MekhyW/Drone-VFHL-R1/GIROSCÓPIO/pinout-6050.png

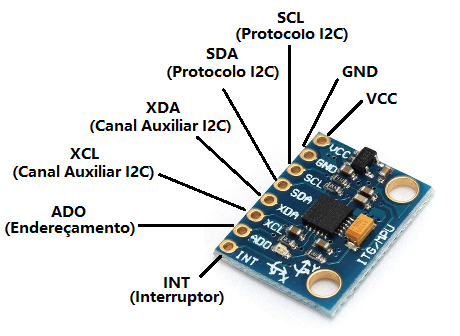
GIROSCÓPIO/pinout-6050.png
