MekhyW/Drone-VFHL-R1/IMAGE/2.jpeg

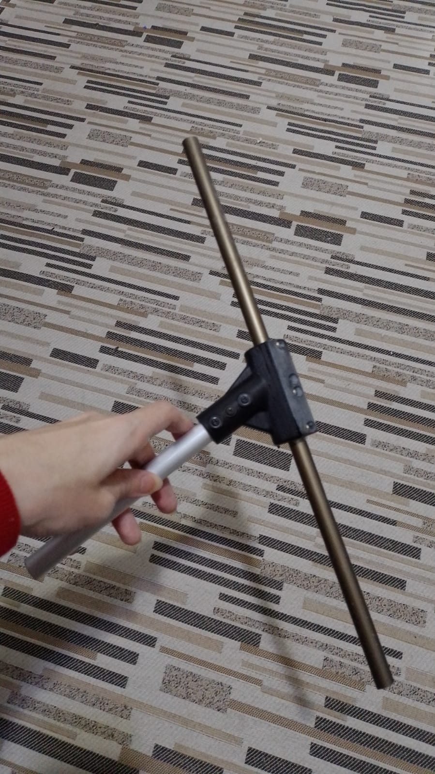
IMAGE/2.jpeg
