MekhyW/Drone-VFHL-R1/DOCUMENTOS/Peças para o projeto .pdf

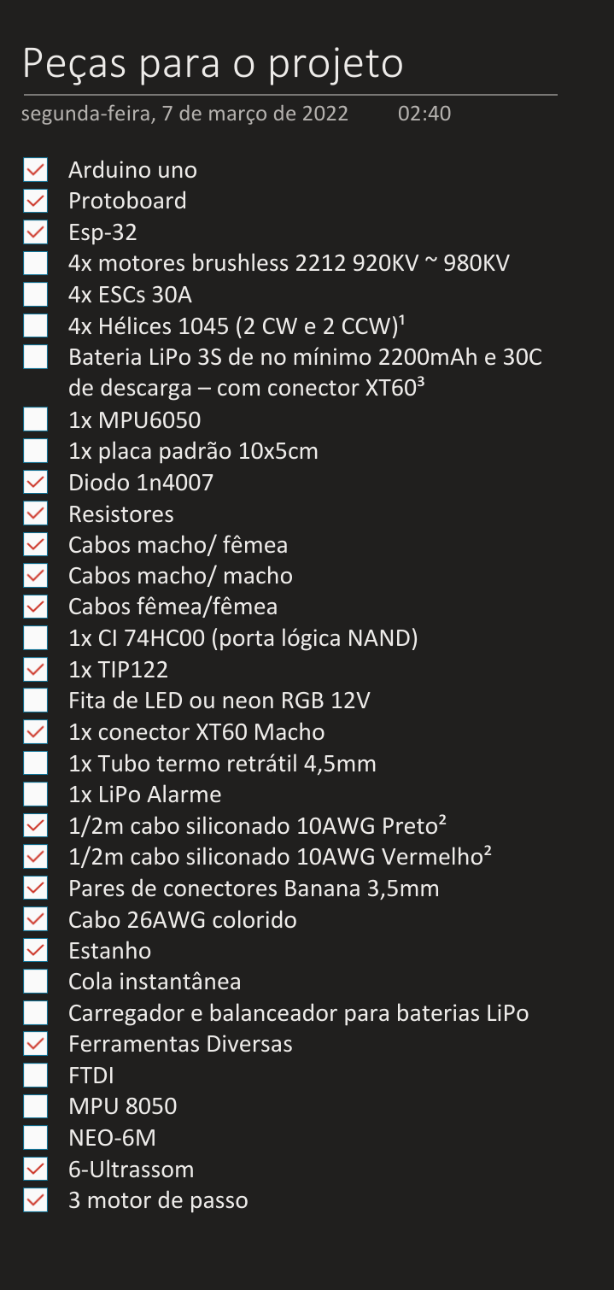
[picture p32: page 1]
