MekhyW/Drone-VFHL-R1/BLUETOOTH/Bluetooth_Level_Converter.png

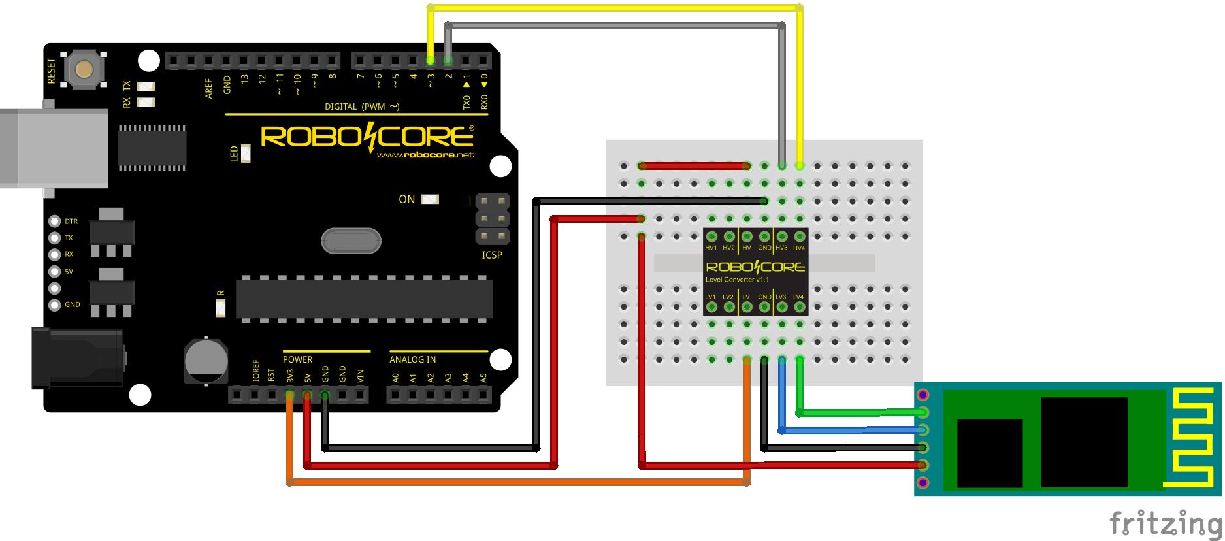
BLUETOOTH/Bluetooth_Level_Converter.png
