MekhyW/Drone-VFHL-R1/Camera Thermal/Camera Thermal/Camera Thermal/Sensor e Display Temp/Fig-4-Potenciometro-ligado-como-divisor-de-tensão-min.webp

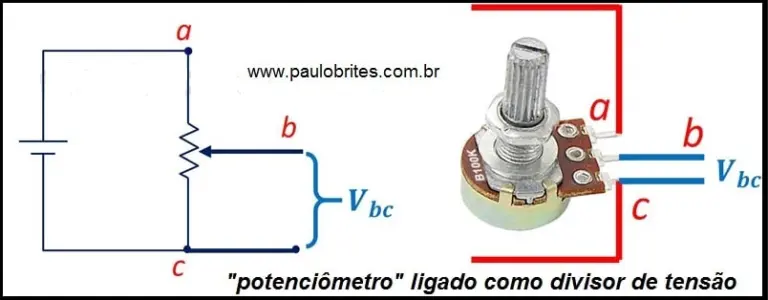
Camera Thermal/Camera Thermal/Camera Thermal/Sensor e Display Temp/Fig-4-Potenciometro-ligado-como-divisor-de-tensão-min.webp
