MekhyW/Drone-VFHL-R1/Camera Thermal/Camera Thermal/Camera Thermal/Sensor e Display Temp/layout.png

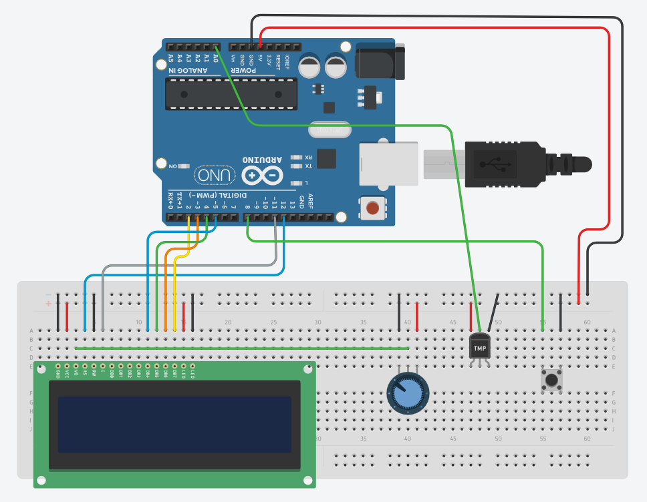
Camera Thermal/Camera Thermal/Camera Thermal/Sensor e Display Temp/layout.png
