MekhyW/Drone-VFHL-R1/Camera Thermal/Camera Thermal/Camera Thermal/Sensor e Display Temp/projeto39.jpg

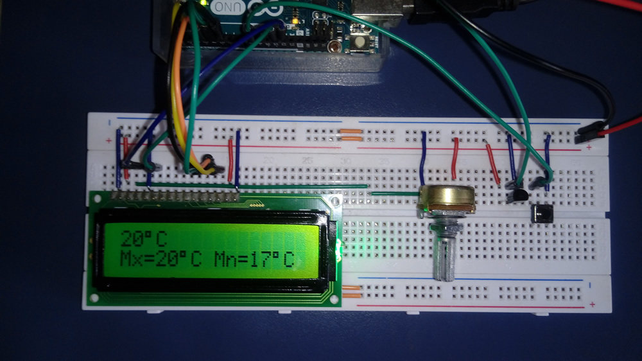
Camera Thermal/Camera Thermal/Camera Thermal/Sensor e Display Temp/projeto39.jpg
