MekhyW/Drone-VFHL-R1/Camera Thermal/Camera Thermal/Camera Thermal/Sensor e Display Temp/Schematic.webp

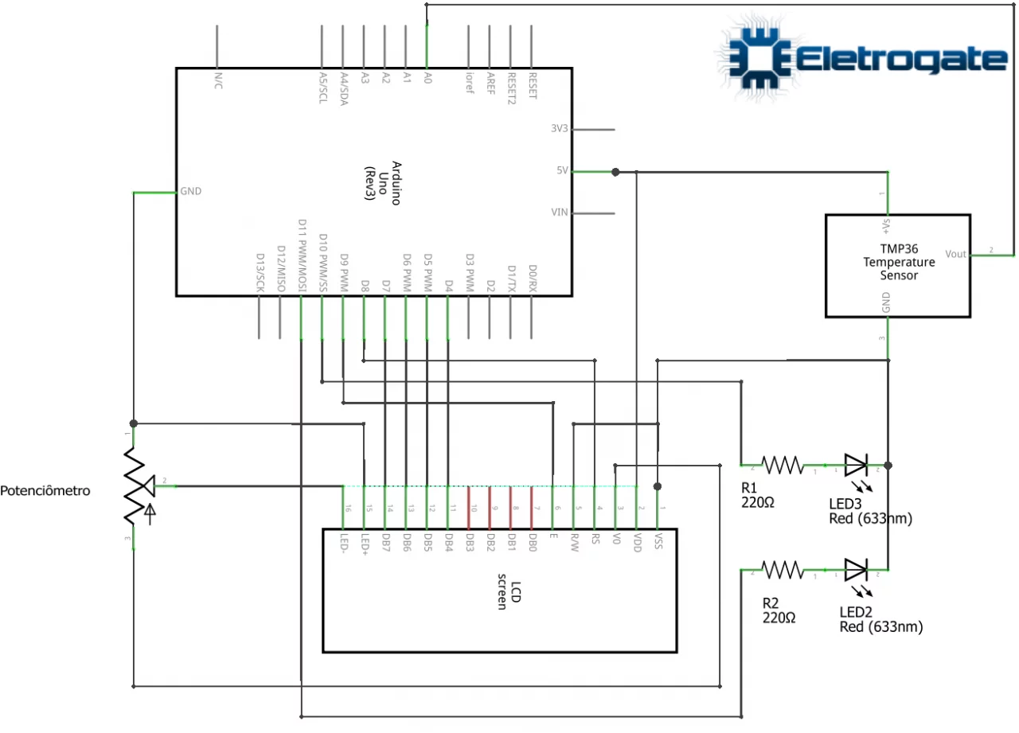
Camera Thermal/Camera Thermal/Camera Thermal/Sensor e Display Temp/Schematic.webp
