MekhyW/Drone-VFHL-R1/Camera Thermal/Camera Thermal/Camera Thermal/Sensor e Display Temp/webpc-passthru (1).webp

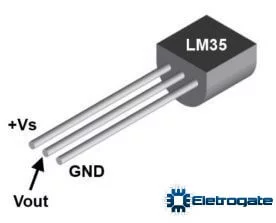
Camera Thermal/Camera Thermal/Camera Thermal/Sensor e Display Temp/webpc-passthru (1).webp
