MekhyW/Drone-VFHL-R1/Camera Thermal/Camera Thermal/Camera Thermal/Sensor e Display Temp/webpc-passthru.webp

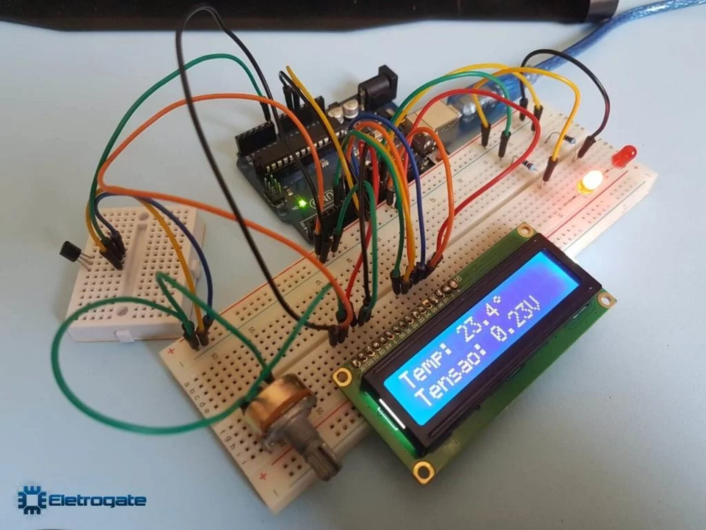
Camera Thermal/Camera Thermal/Camera Thermal/Sensor e Display Temp/webpc-passthru.webp
