MekhyW/Drone-VFHL-R1/Camera Thermal/Camera Thermal/Camera Thermal/virtualPainel.png

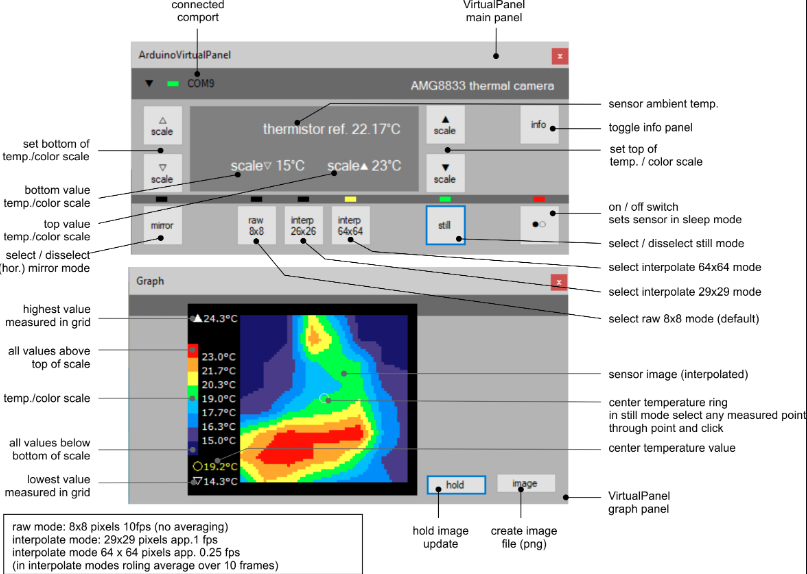
Camera Thermal/Camera Thermal/Camera Thermal/virtualPainel.png
