MekhyW/Drone-VFHL-R1/Camera Thermal/Camera Thermal/Datasheet.png

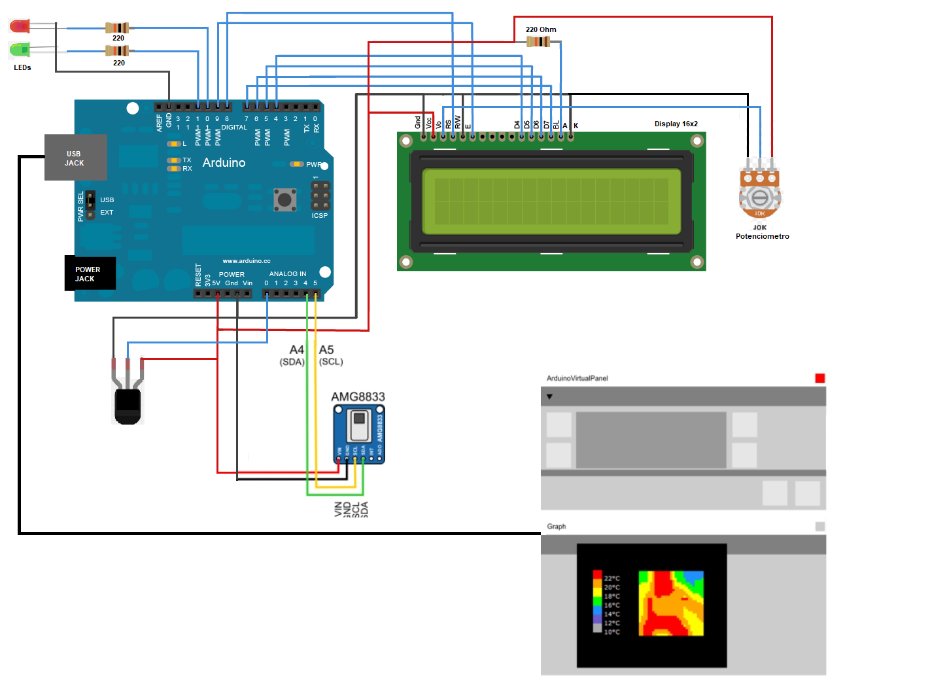
Camera Thermal/Camera Thermal/Datasheet.png
