MekhyW/Drone-VFHL-R1/DOCUMENTOS/CI 74HC00.png

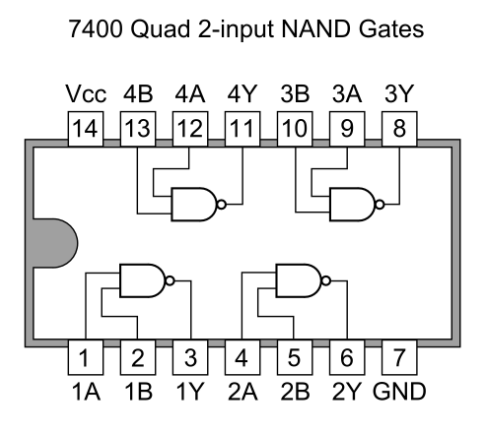
DOCUMENTOS/CI 74HC00.png
