MekhyW/Drone-VFHL-R1/DOCUMENTOS/Diagrama Completo.png

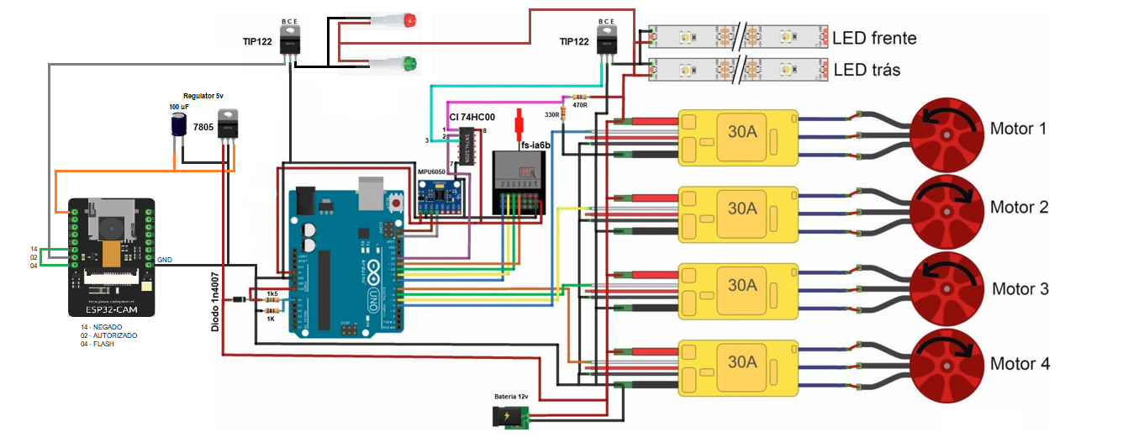
DOCUMENTOS/Diagrama Completo.png
