MekhyW/Drone-VFHL-R1/DOCUMENTOS/esquematico-quad-2-scaled-1-1536x750.jpg

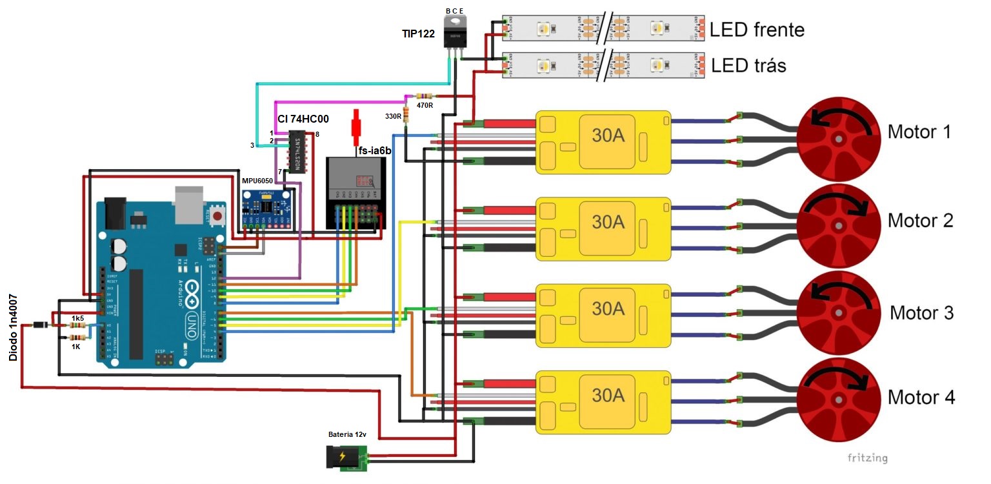
DOCUMENTOS/esquematico-quad-2-scaled-1-1536x750.jpg
