MekhyW/Drone-VFHL-R1/DOCUMENTOS/SUPORTE FLYSKY.png

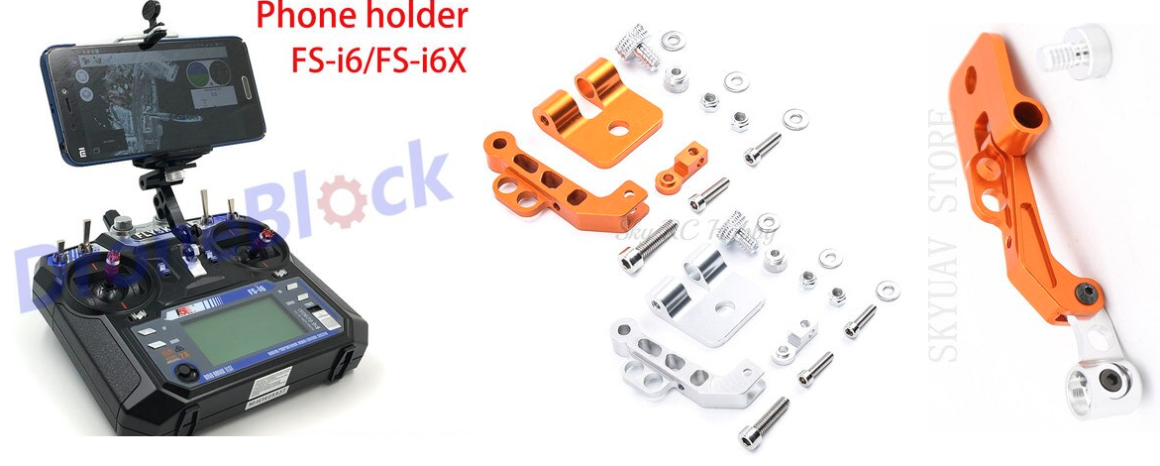
DOCUMENTOS/SUPORTE FLYSKY.png
