MekhyW/Drone-VFHL-R1/DOCUMENTOS/TIP122.png

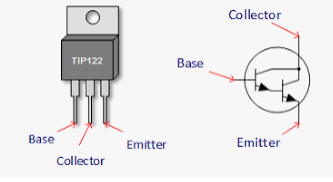
DOCUMENTOS/TIP122.png
