MekhyW/Drone-VFHL-R1/ESC/Circuito-Arduino-Uno-Motor-Brushless-1024x719.png

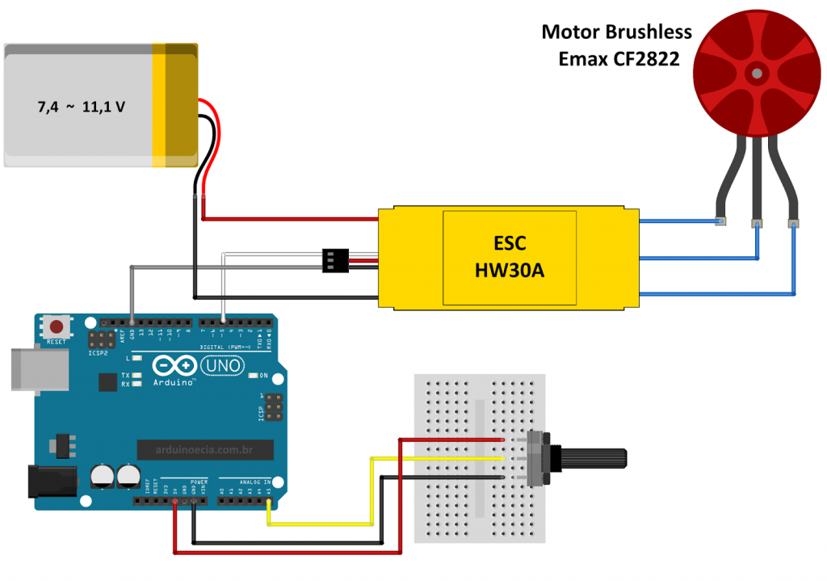
ESC/Circuito-Arduino-Uno-Motor-Brushless-1024x719.png
