MekhyW/Drone-VFHL-R1/ESP32/ESP32-CAM_FTDI_3bb.png

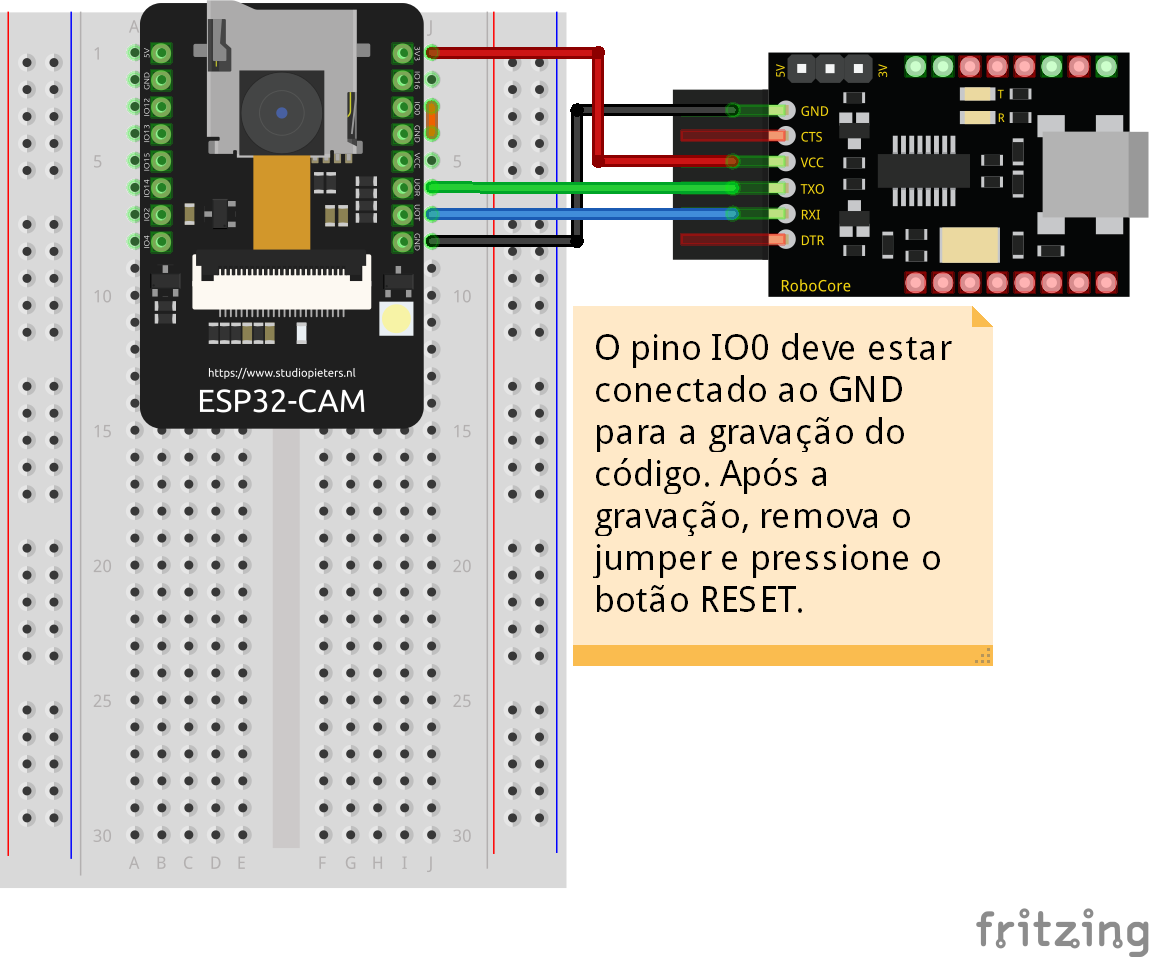
ESP32/ESP32-CAM_FTDI_3bb.png
