MekhyW/Drone-VFHL-R1/ESP32/features-esp32.png

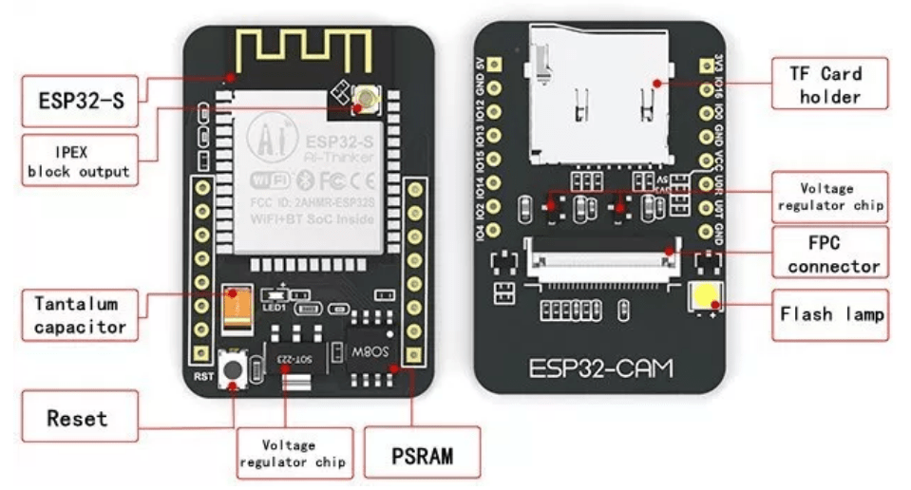
ESP32/features-esp32.png
