MekhyW/Drone-VFHL-R1/GIROSCÓPIO/circuito_dois_mpu6050-768x534.jpg

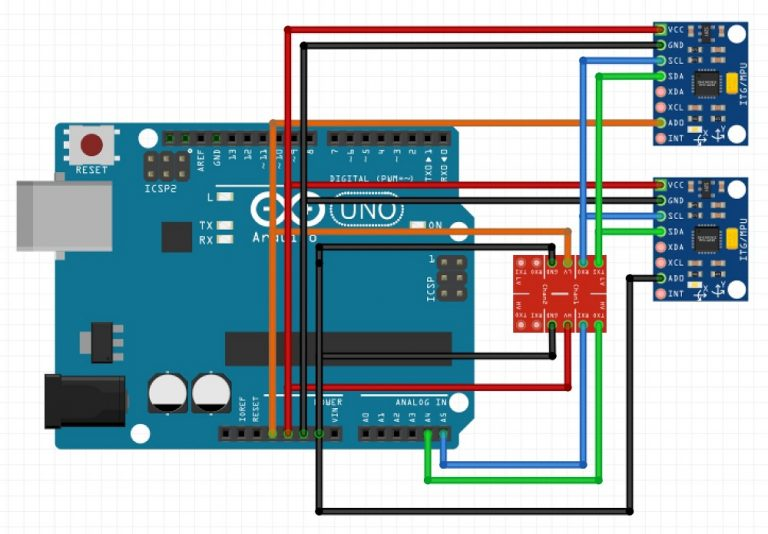
GIROSCÓPIO/circuito_dois_mpu6050-768x534.jpg
