MekhyW/Drone-VFHL-R1/GIROSCÓPIO/circuito_mpu6050-768x440.jpg

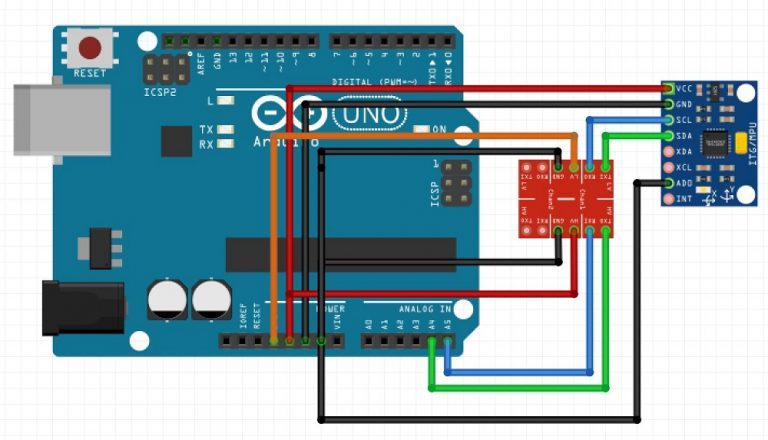
GIROSCÓPIO/circuito_mpu6050-768x440.jpg
