MekhyW/Drone-VFHL-R1/GIROSCÓPIO/GY-521-MPU-6050-Pinos1.jpg

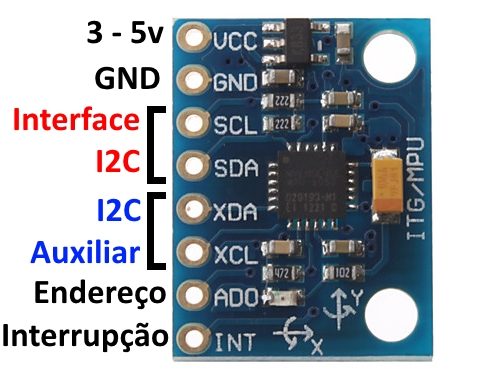
GIROSCÓPIO/GY-521-MPU-6050-Pinos1.jpg
