MekhyW/Drone-VFHL-R1/IMAGE/4.jpeg

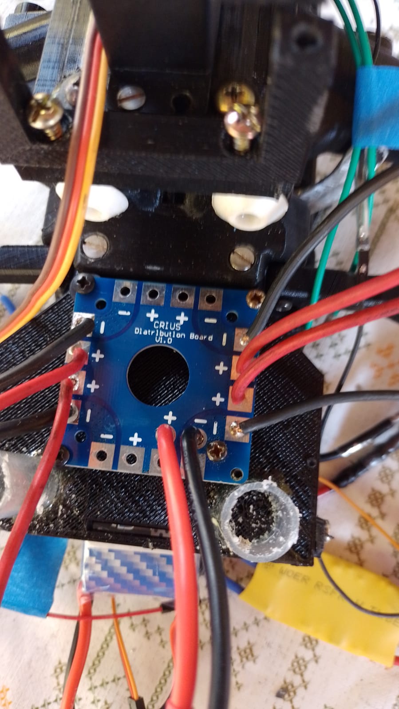
IMAGE/4.jpeg
