MekhyW/Drone-VFHL-R1/IMAGE/5.jpeg

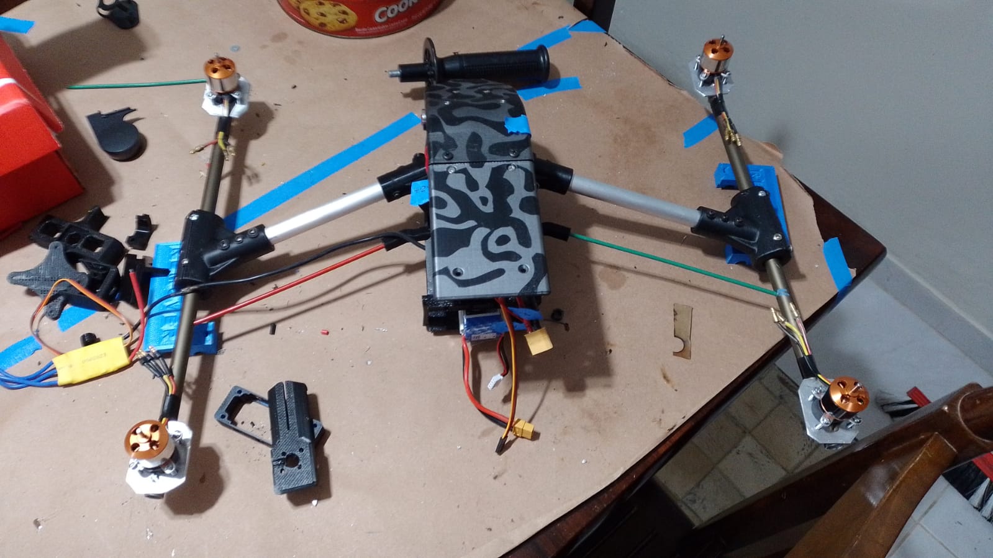
IMAGE/5.jpeg
