MekhyW/Drone-VFHL-R1/IMAGE/6.jpeg

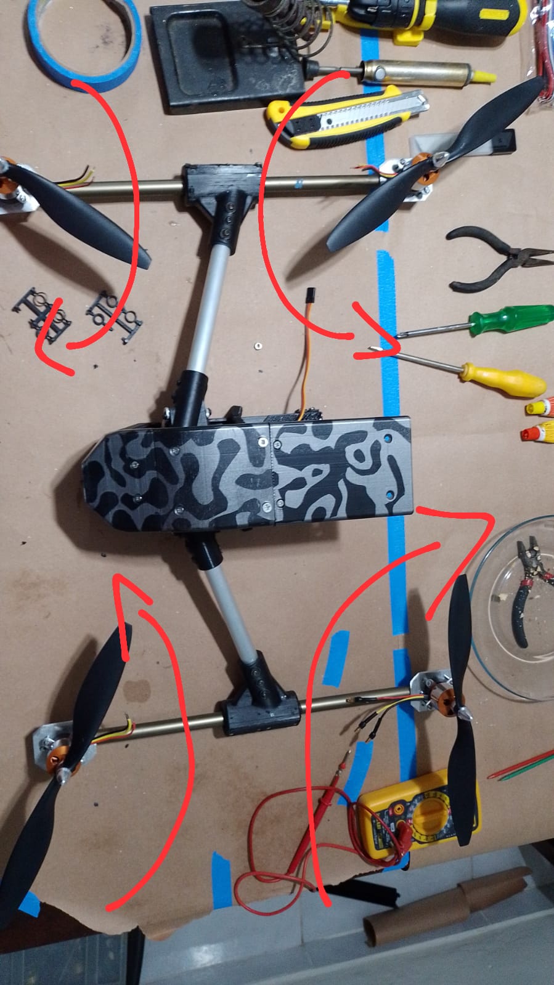
IMAGE/6.jpeg
