MekhyW/Drone-VFHL-R1/IMAGE/WhatsApp Image 2022-05-19 at 20.57.54.jpeg

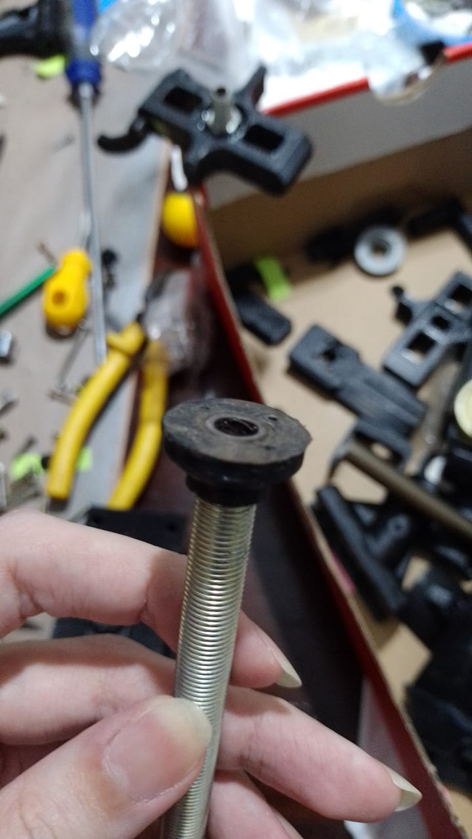
IMAGE/WhatsApp Image 2022-05-19 at 20.57.54.jpeg
