MekhyW/Drone-VFHL-R1/IMAGE/WhatsApp Image 2022-05-21 at 18.13.55 (1).jpeg

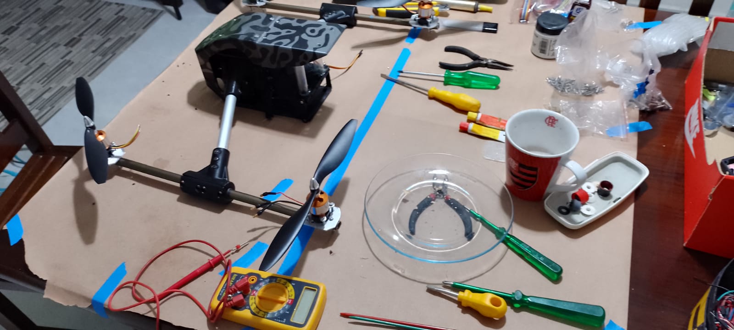
IMAGE/WhatsApp Image 2022-05-21 at 18.13.55 (1).jpeg
