MekhyW/Drone-VFHL-R1/IMAGE/WhatsApp Image 2022-05-21 at 18.13.55 (2).jpeg

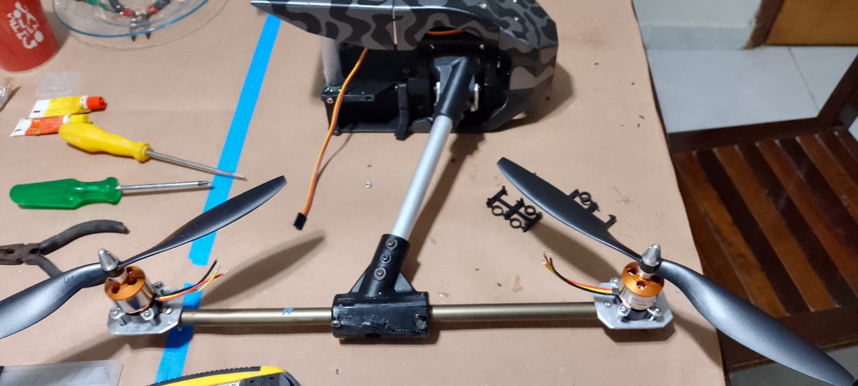
IMAGE/WhatsApp Image 2022-05-21 at 18.13.55 (2).jpeg
