MekhyW/Drone-VFHL-R1/MicroSD/827_3_H.png

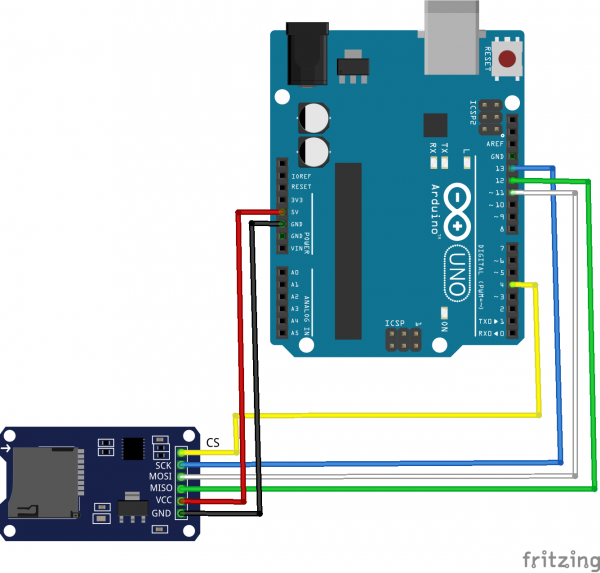
MicroSD/827_3_H.png
