MekhyW/Drone-VFHL-R1/Modulo ESP32/CONFIG IDE 1.png

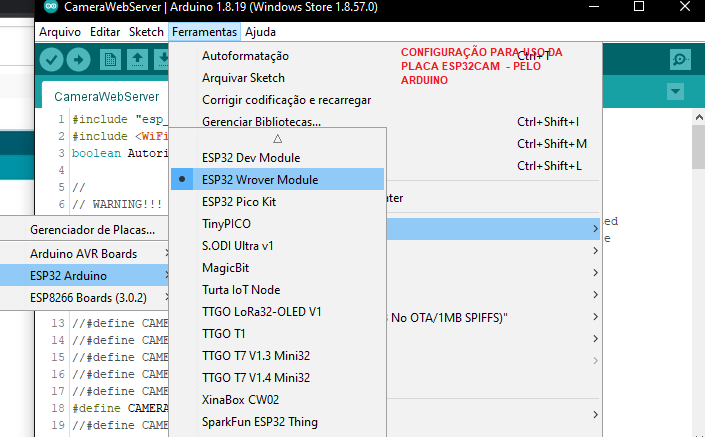
Modulo ESP32/CONFIG IDE 1.png
