MekhyW/Drone-VFHL-R1/Modulo Esp8266/esp_blackversion_ftdi_955.png

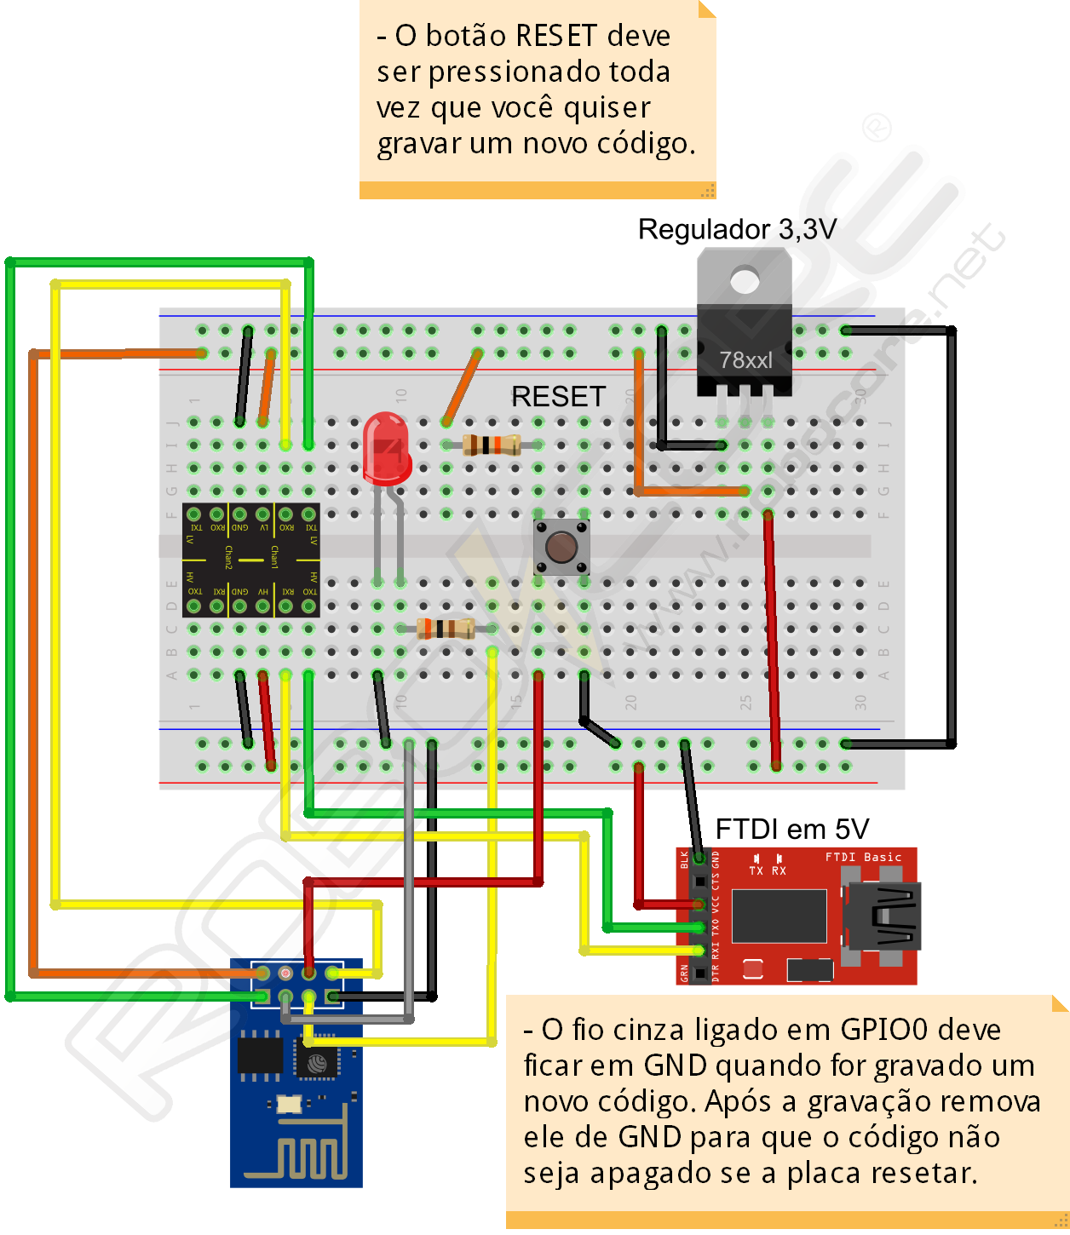
Modulo Esp8266/esp_blackversion_ftdi_955.png
