MekhyW/Drone-VFHL-R1/PCB/1.bmp

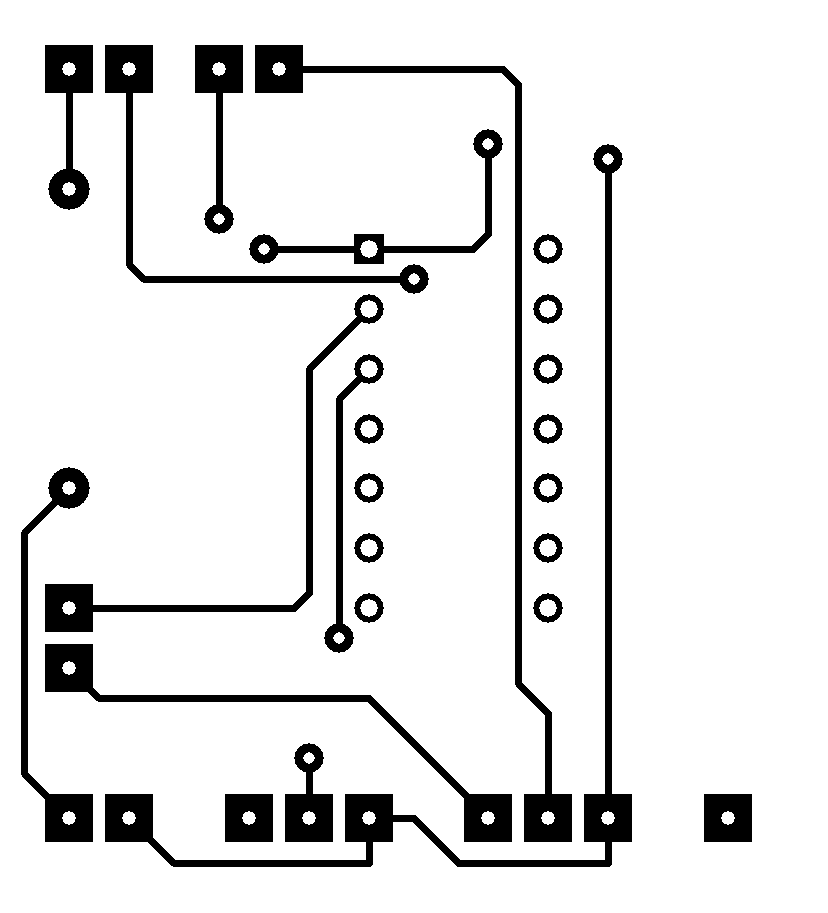
PCB/1.bmp
