MekhyW/Drone-VFHL-R1/PCB/2.bmp

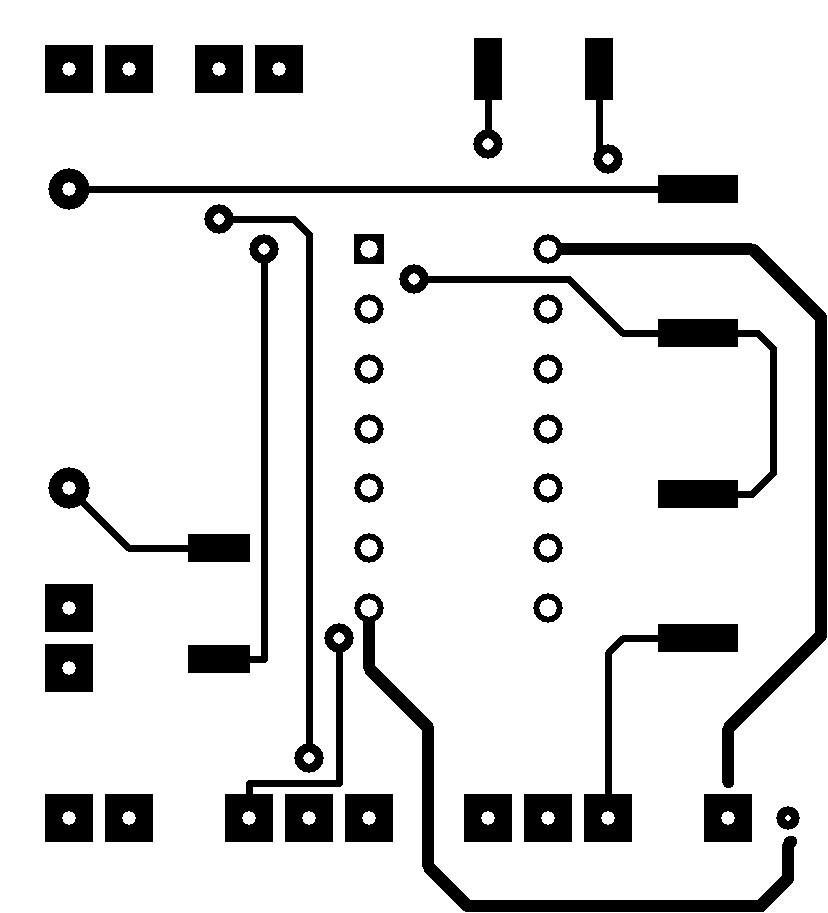
PCB/2.bmp
