MekhyW/Drone-VFHL-R1/DOCUMENTOS/orçamento projeto.xlsx

Quantidade | peças | mercado livre | aliexpress | shoppe | banggood | americanas
4 | Motor Brushless 2212 920KV | R$99.35 | R$145.81 | R$179.12 | R$211.31 | R$94.95
4 | ESCs 30A | R$169.20 | R$207.28 | R$159.60 | R$152.79 | R$265.20
1 | Bateria LiPo 3s 2200mAh | R$144.40 | R$203.57 | R$129.00 | R$154.28 | R$203.62
1 | tubo termo retratil | R$46.30 | R$68.89 | R$26.50 | R$57.03 | R$51.98
1 | carregador e balanceador para bateria LiPo | R$205.20 | R$182.32 | R$130.00 | R$224.00 | R$82.77
1 | Neo-6m (gps) | R$61.99 | R$75.92 | R$38.28 | / | R$74.55
