MekhyW/Drone-VFHL-R1/DRONE 3D/Drone PGE Esamc/Wormdrive_V1.5_M8Round.stl

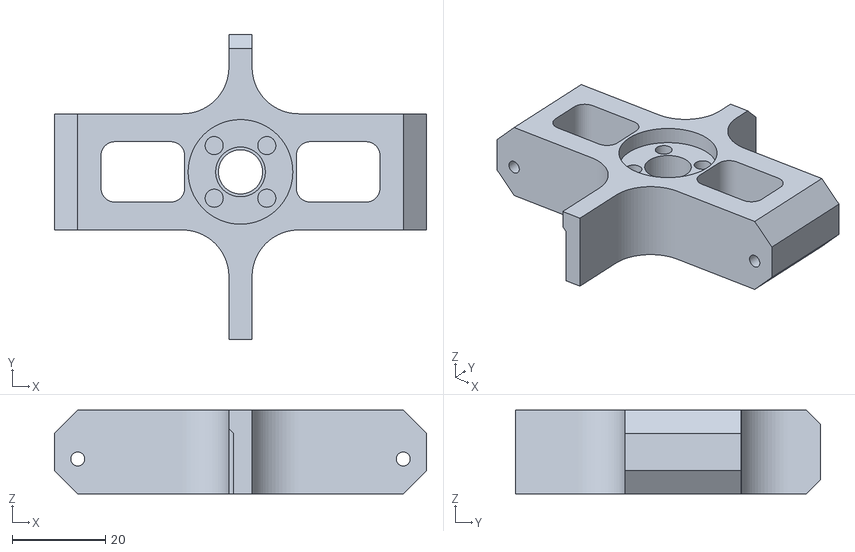
[picture p72: CAD file, 2023-11-14]
DRONE 3D/Drone PGE Esamc/Wormdrive_V1.5_M8Round.stl
80.0 x 65.5 x 18.0
