MekhyW/Drone-VFHL-R1/DRONE 3D/Drone PGE Esamc/Frame_Bushing_Holder_Front_V1.5.stl

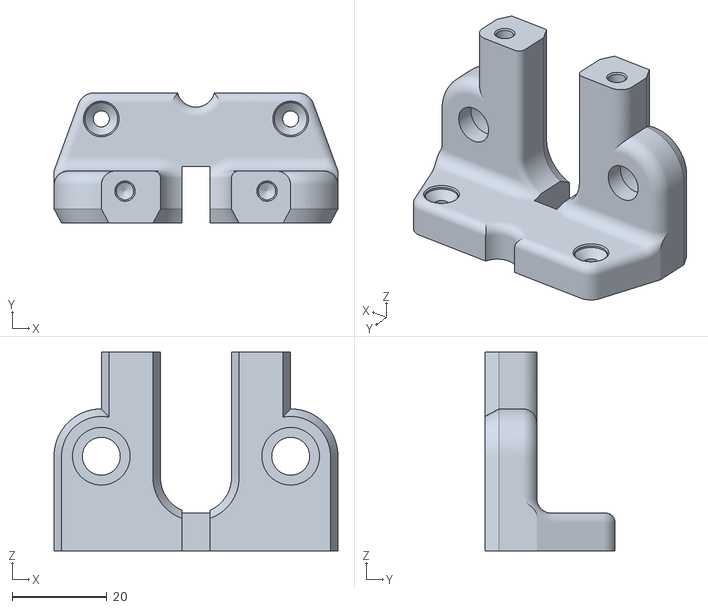
[picture p73: CAD file, 2023-11-14]
DRONE 3D/Drone PGE Esamc/Frame_Bushing_Holder_Front_V1.5.stl
60.0 x 27.5 x 42.0
