MekhyW/Drone-VFHL-R1/DRONE 3D/Drone PGE Esamc/Frame_Bushing_Holder_Rear_V1.5.stl

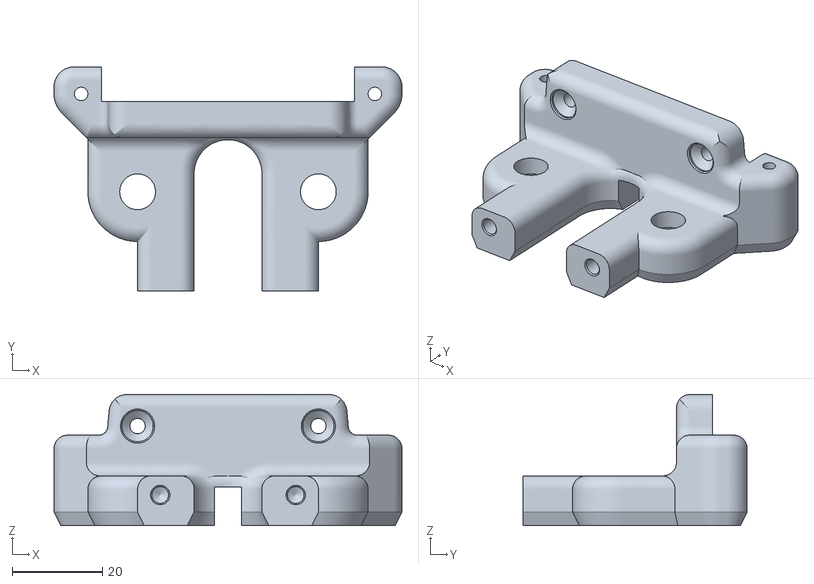
[picture p74: CAD file, 2023-11-14]
DRONE 3D/Drone PGE Esamc/Frame_Bushing_Holder_Rear_V1.5.stl
77.0 x 49.7 x 29.0
