MekhyW/Drone-VFHL-R1/DRONE 3D/Drone PGE Esamc/Boom_Outer_Joint_2_20Deg_R.stl

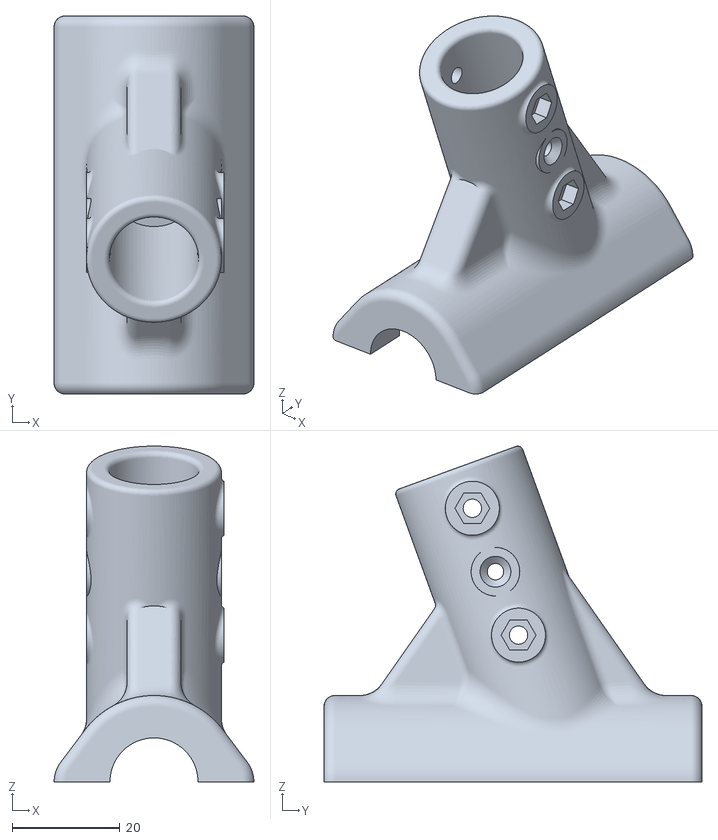
[picture p75: CAD file, 2023-11-14]
DRONE 3D/Drone PGE Esamc/Boom_Outer_Joint_2_20Deg_R.stl
37.0 x 70.0 x 62.2
