MekhyW/Drone-VFHL-R1/DRONE 3D/Drone PGE Esamc/Frame_Joint_Bushing_V1.5.stl

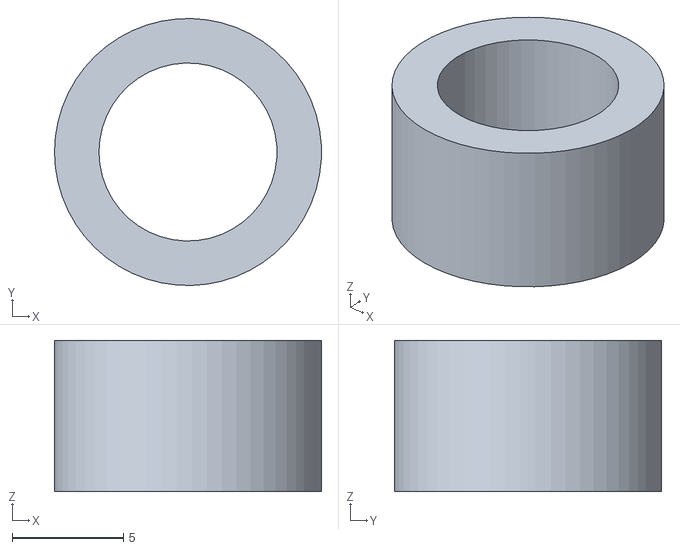
[picture p76: CAD file, 2023-11-14]
DRONE 3D/Drone PGE Esamc/Frame_Joint_Bushing_V1.5.stl
12.0 x 12.0 x 6.80
