MekhyW/Drone-VFHL-R1/DRONE 3D/Drone PGE Esamc/Canopy_Top_V1.5_Split_B.stl

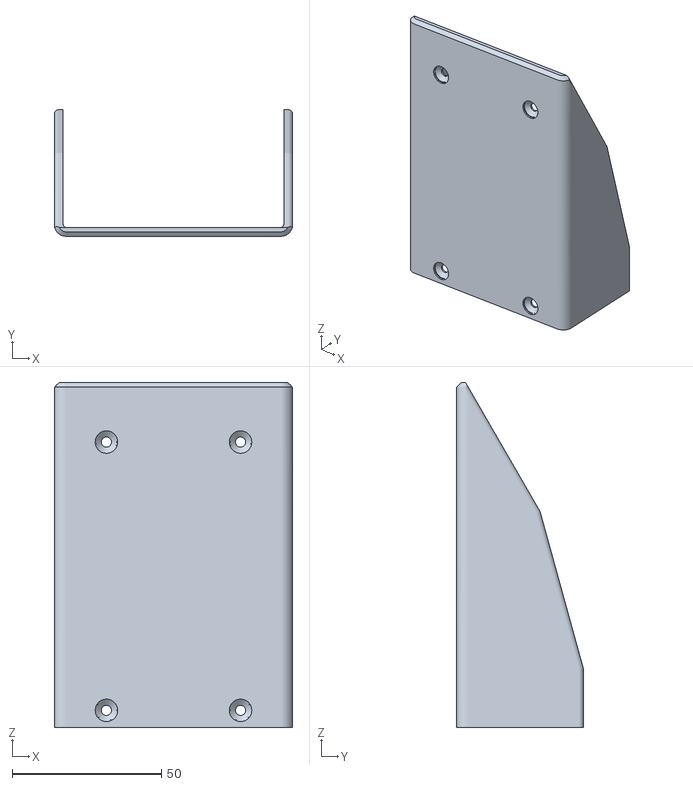
[picture p77: CAD file, 2023-11-14]
DRONE 3D/Drone PGE Esamc/Canopy_Top_V1.5_Split_B.stl
80.0 x 42.5 x 115.7
