MekhyW/Drone-VFHL-R1/DRONE 3D/Drone PGE Esamc/Boom_Support_Linkage_V4_2pc.stl

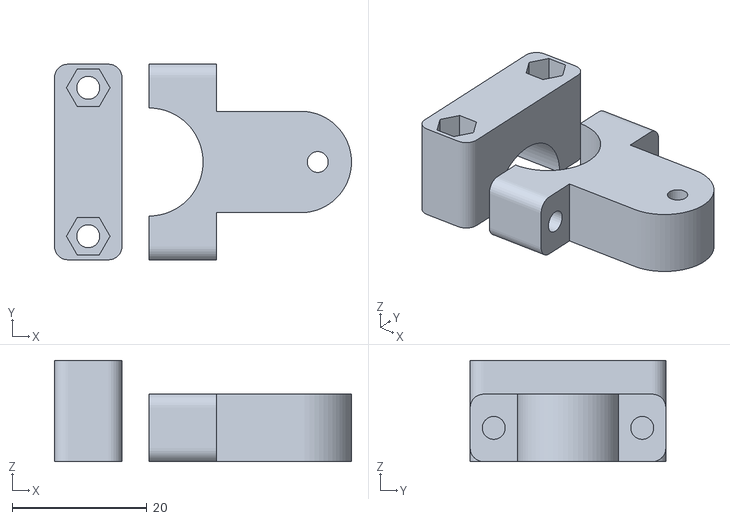
[picture p78: CAD file, 2023-11-14]
DRONE 3D/Drone PGE Esamc/Boom_Support_Linkage_V4_2pc.stl
44.0 x 29.0 x 15.0
