MekhyW/Drone-VFHL-R1/DRONE 3D/Drone PGE Esamc/Boom_Rod_Linkage_20Deg_L.stl

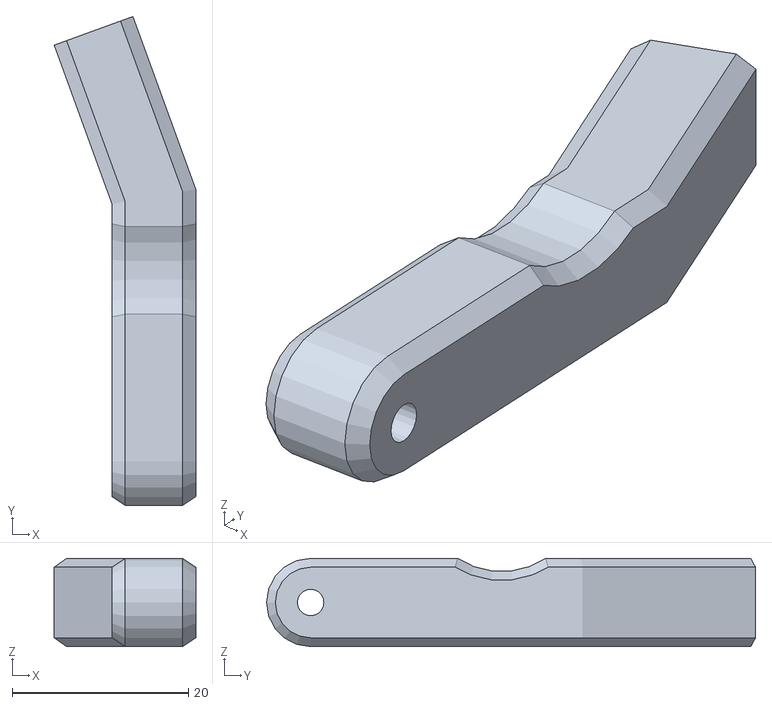
[picture p79: CAD file, 2023-11-14]
DRONE 3D/Drone PGE Esamc/Boom_Rod_Linkage_20Deg_L.stl
16.1 x 55.4 x 10.0
