MekhyW/Drone-VFHL-R1/DRONE 3D/Drone PGE Esamc/Clamp_Angle_Guide.stl

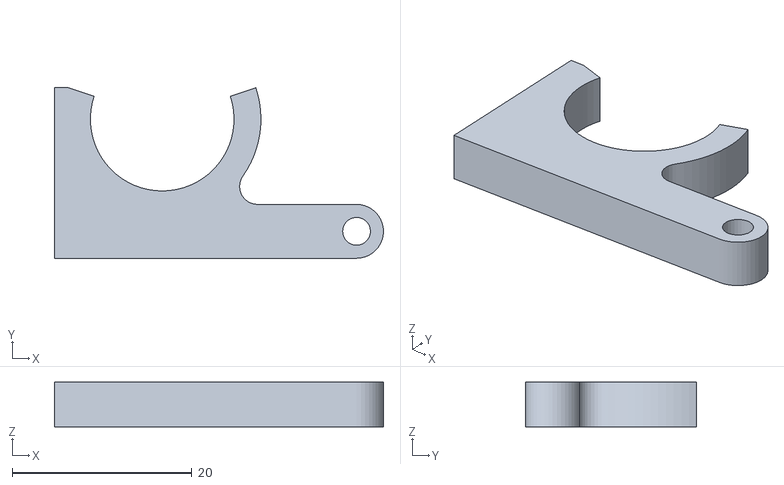
[picture p80: CAD file, 2023-11-14]
DRONE 3D/Drone PGE Esamc/Clamp_Angle_Guide.stl
36.7 x 19.0 x 5.00
