MekhyW/Drone-VFHL-R1/DRONE 3D/Drone PGE Esamc/Frame_Receiver_Shelf_90mm_V1.5.stl

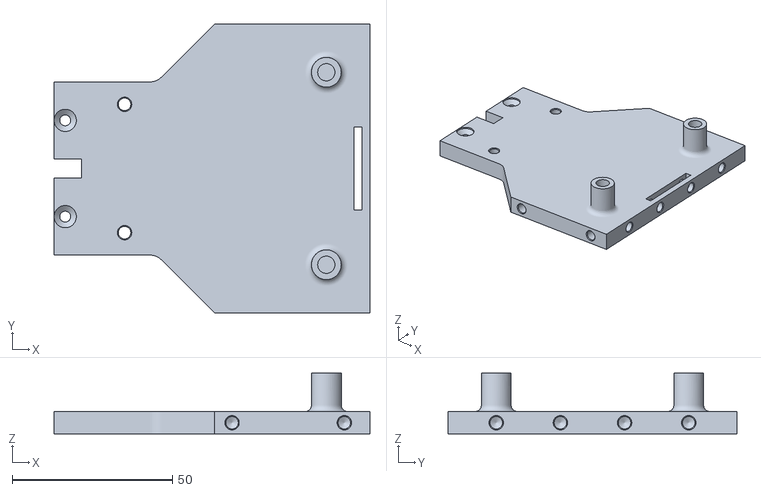
[picture p81: CAD file, 2023-11-14]
DRONE 3D/Drone PGE Esamc/Frame_Receiver_Shelf_90mm_V1.5.stl
98.5 x 90.0 x 19.0
