MekhyW/Drone-VFHL-R1/DRONE 3D/Drone PGE Esamc/Boom_Stop_Ring_V3_2pc.stl

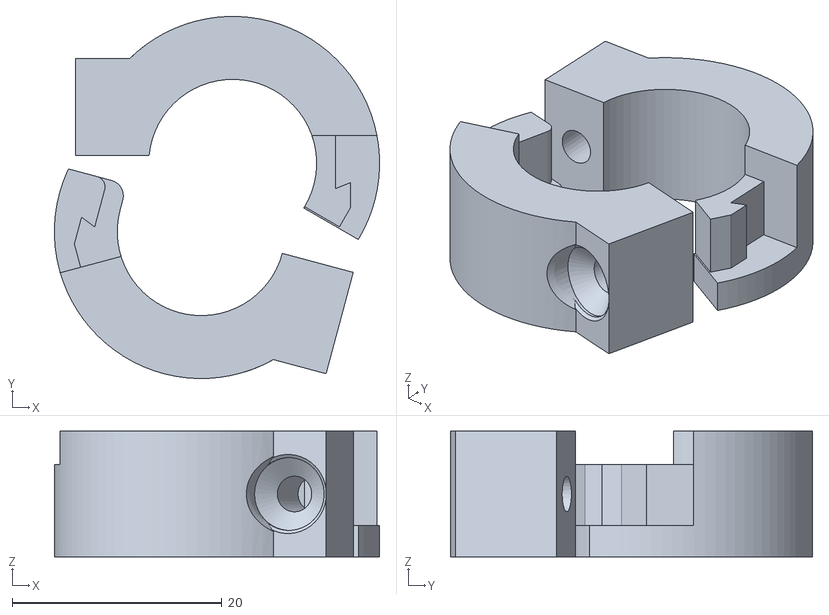
[picture p83: CAD file, 2023-11-14]
DRONE 3D/Drone PGE Esamc/Boom_Stop_Ring_V3_2pc.stl
31.0 x 34.5 x 12.0
