MekhyW/Drone-VFHL-R1/DRONE 3D/Drone PGE Esamc/Frame_Motor_Foot_1_V1.5.stl

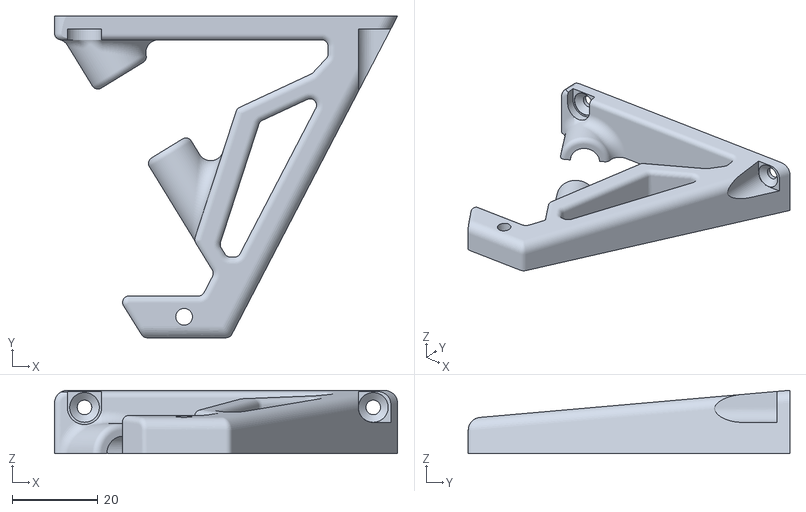
[picture p84: CAD file, 2023-11-14]
DRONE 3D/Drone PGE Esamc/Frame_Motor_Foot_1_V1.5.stl
80.0 x 75.0 x 14.8
