MekhyW/Drone-VFHL-R1/DRONE 3D/Drone PGE Esamc/Canopy_Nose_FPV_V1.5.stl

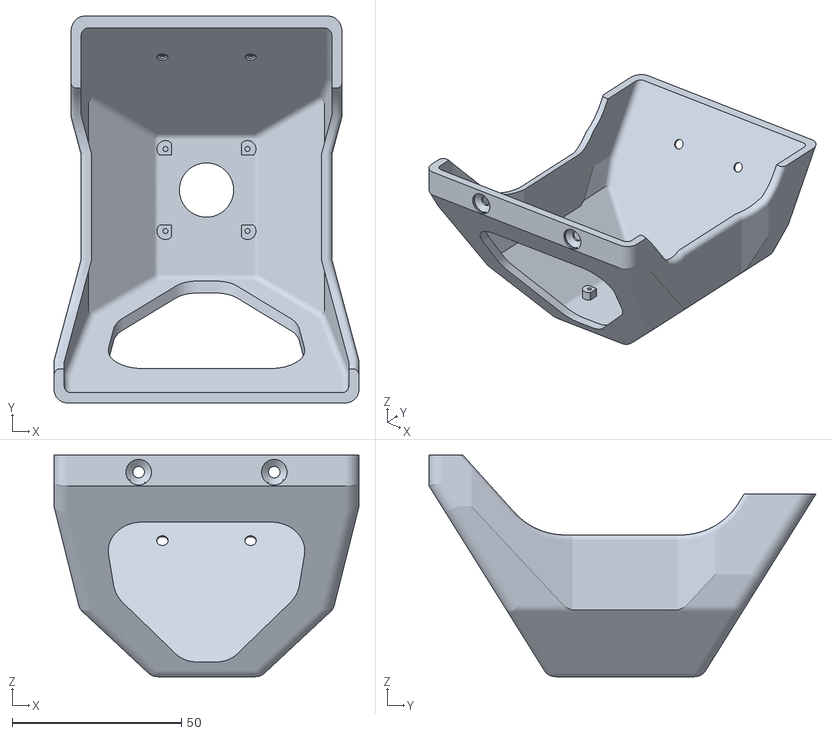
[picture p85: CAD file, 2023-11-14]
DRONE 3D/Drone PGE Esamc/Canopy_Nose_FPV_V1.5.stl
90.0 x 114.1 x 65.4
