MekhyW/Drone-VFHL-R1/DRONE 3D/Drone PGE Esamc/Gimbal_Frame_V1.5.stl

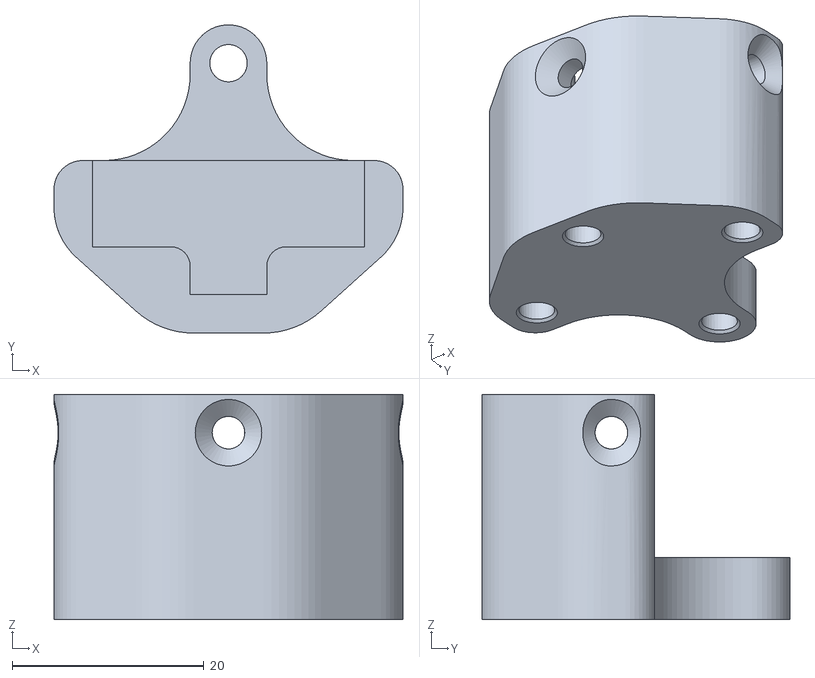
[picture p86: CAD file, 2023-11-14]
DRONE 3D/Drone PGE Esamc/Gimbal_Frame_V1.5.stl
36.4 x 32.1 x 23.5
