MekhyW/Drone-VFHL-R1/DRONE 3D/Drone PGE Esamc/Gimbal_Plate_Diam_40mm_X.stl

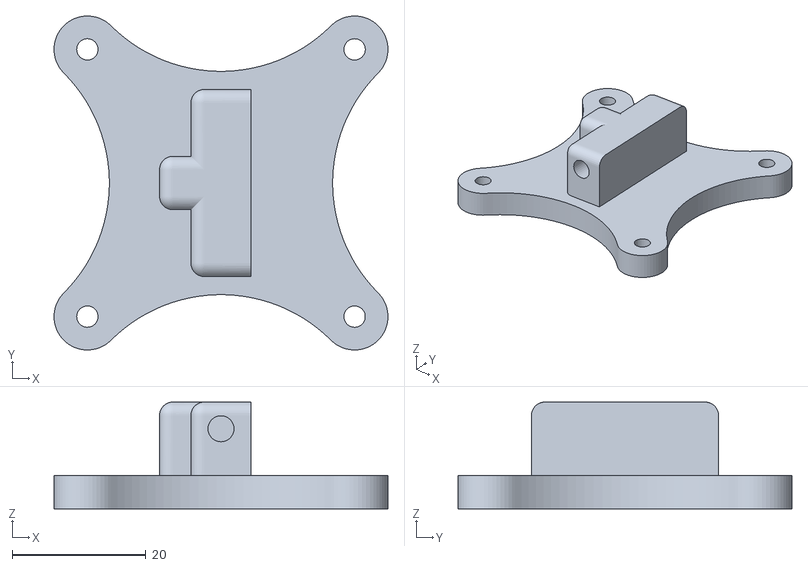
[picture p87: CAD file, 2023-11-14]
DRONE 3D/Drone PGE Esamc/Gimbal_Plate_Diam_40mm_X.stl
50.0 x 50.0 x 16.0
