MekhyW/Drone-VFHL-R1/DRONE 3D/Drone PGE Esamc/Frame_Strengthener_V1.5.stl

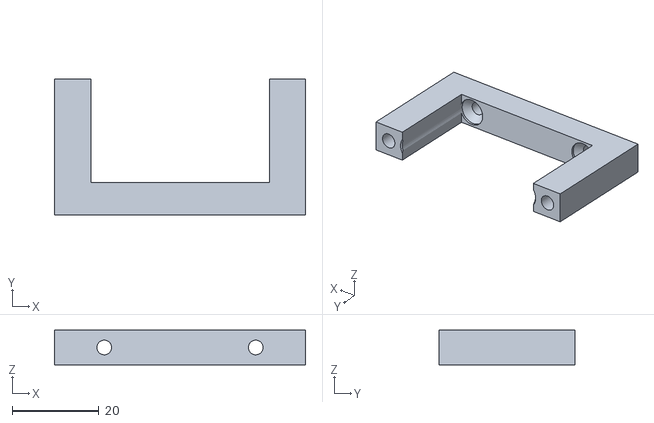
[picture p88: CAD file, 2023-11-14]
DRONE 3D/Drone PGE Esamc/Frame_Strengthener_V1.5.stl
58.0 x 31.4 x 8.00
