MekhyW/Drone-VFHL-R1/DRONE 3D/Drone PGE Esamc/Frame_Top_V1.5.stl

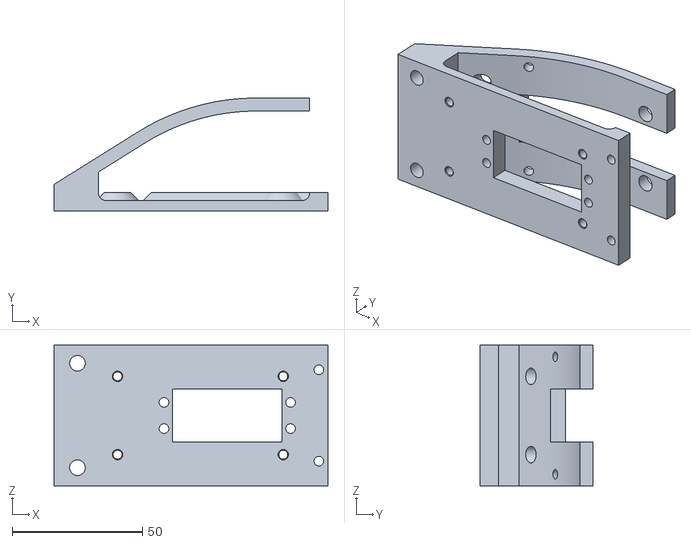
[picture p89: CAD file, 2023-11-14]
DRONE 3D/Drone PGE Esamc/Frame_Top_V1.5.stl
105.0 x 43.3 x 54.0
