MekhyW/Drone-VFHL-R1/DRONE 3D/Drone PGE Esamc/Frame_Motor_Mount_V1.5.stl

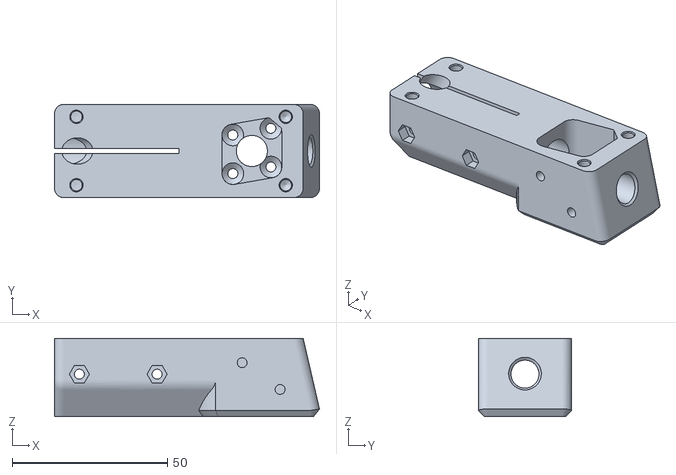
[picture p91: CAD file, 2023-11-14]
DRONE 3D/Drone PGE Esamc/Frame_Motor_Mount_V1.5.stl
85.3 x 30.0 x 25.2
