MekhyW/Drone-VFHL-R1/DRONE 3D/Drone PGE Esamc/LED_Clip_V2.stl

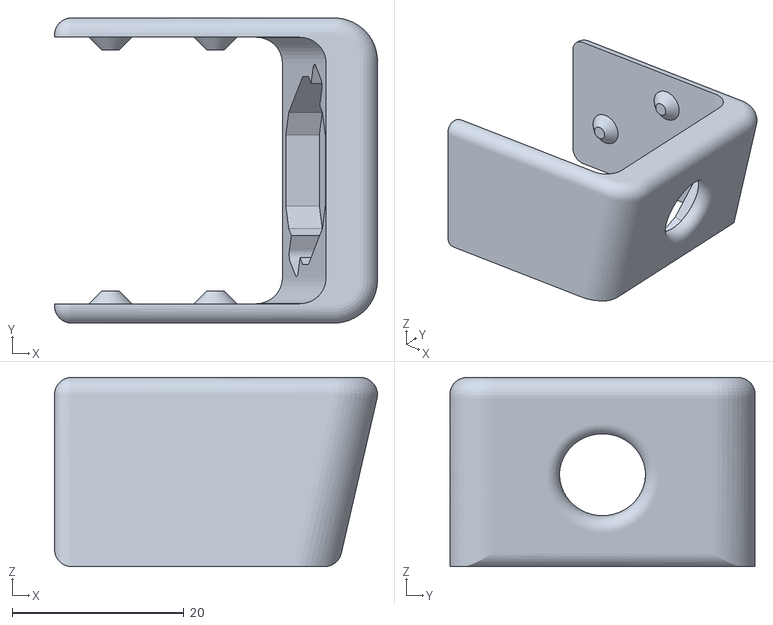
[picture p92: CAD file, 2023-11-14]
DRONE 3D/Drone PGE Esamc/LED_Clip_V2.stl
37.6 x 35.5 x 22.0
