MekhyW/Drone-VFHL-R1/DRONE 3D/Drone PGE Esamc/Frame_Motor_ESC_Box_RC-CAM.stl

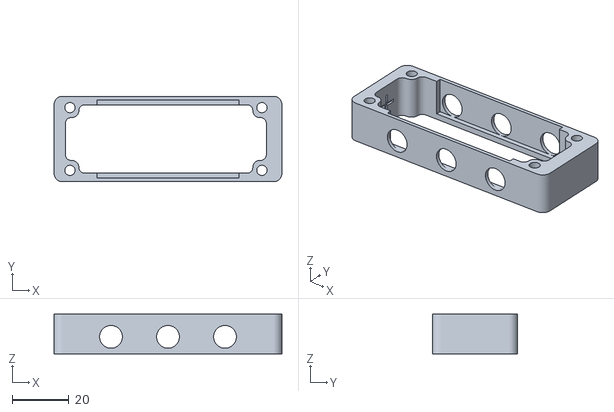
[picture p93: CAD file, 2023-11-14]
DRONE 3D/Drone PGE Esamc/Frame_Motor_ESC_Box_RC-CAM.stl
80.0 x 30.0 x 14.0
