MekhyW/Drone-VFHL-R1/DRONE 3D/Drone PGE Esamc/Drill_Guide_V1.5.stl

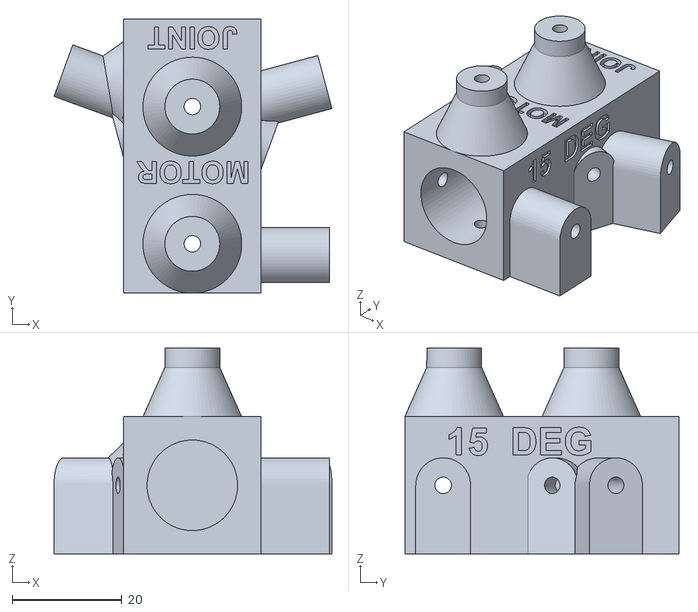
[picture p94: CAD file, 2023-11-14]
DRONE 3D/Drone PGE Esamc/Drill_Guide_V1.5.stl
50.6 x 50.0 x 37.5
