MekhyW/Drone-VFHL-R1/DRONE 3D/Drone PGE Esamc/Canopy_Top_V1.5_Split_A.stl

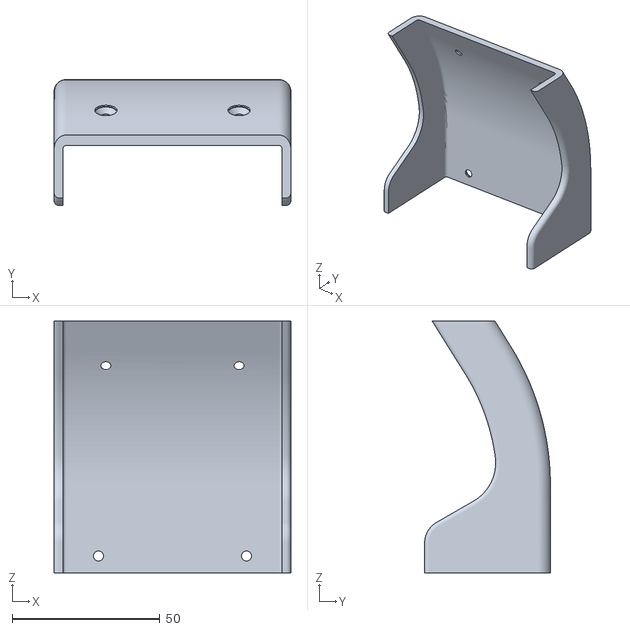
[picture p95: CAD file, 2023-11-14]
DRONE 3D/Drone PGE Esamc/Canopy_Top_V1.5_Split_A.stl
80.0 x 42.5 x 85.1
