MekhyW/Drone-VFHL-R1/DRONE 3D/Drone PGE Esamc/Boom_Joint_20Deg_R.stl

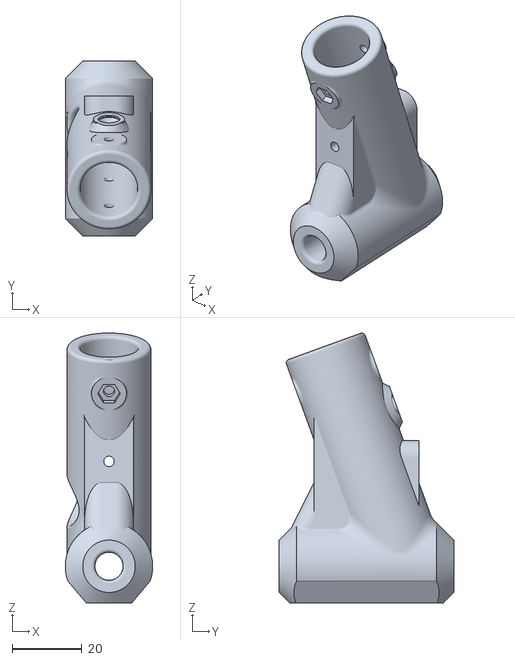
[picture p96: CAD file, 2023-11-14]
DRONE 3D/Drone PGE Esamc/Boom_Joint_20Deg_R.stl
25.0 x 50.0 x 77.2
