MekhyW/Drone-VFHL-R1/DRONE 3D/Drone PGE Esamc/Frame_Bottom_V1.5.stl

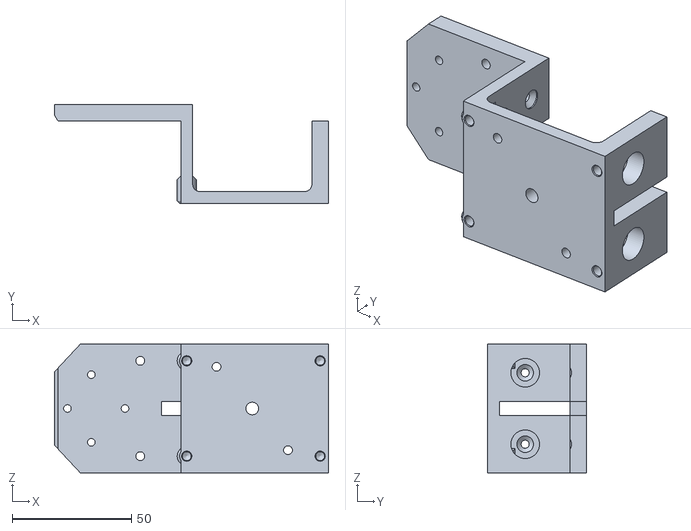
[picture p97: CAD file, 2023-11-14]
DRONE 3D/Drone PGE Esamc/Frame_Bottom_V1.5.stl
115.0 x 41.5 x 54.0
