MekhyW/Drone-VFHL-R1/DRONE 3D/Drone PGE Esamc/Boom_Lift_Linkage_Sweep_2.stl

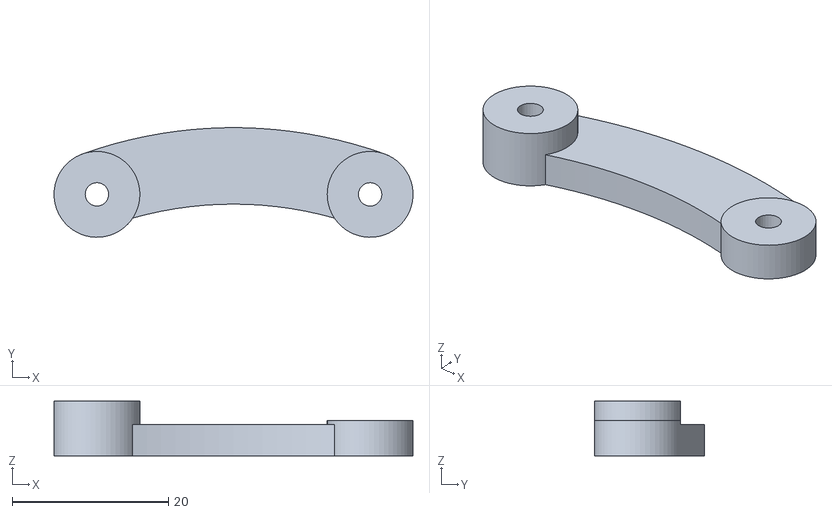
[picture p98: CAD file, 2023-11-14]
DRONE 3D/Drone PGE Esamc/Boom_Lift_Linkage_Sweep_2.stl
46.0 x 14.0 x 7.00
