MekhyW/Drone-VFHL-R1/DRONE 3D/Drone PGE Esamc/Canopy_Tail_V1.5.stl

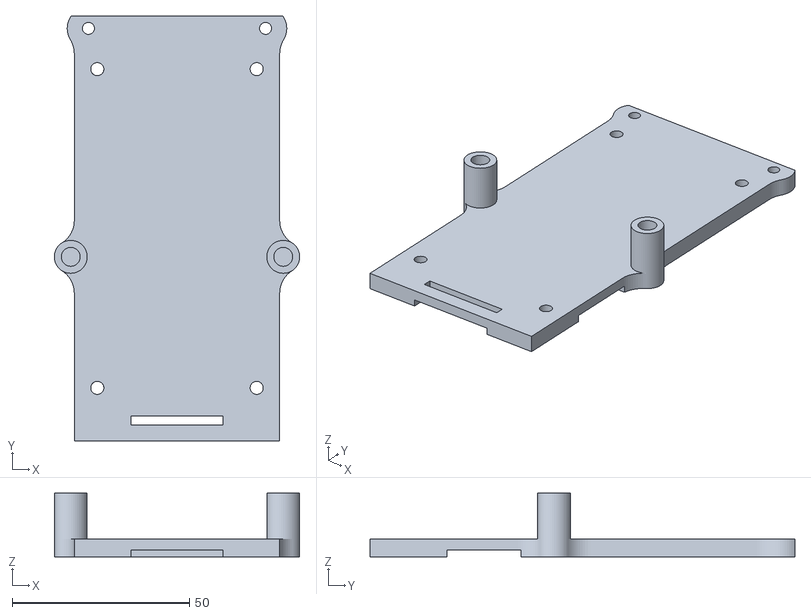
[picture p99: CAD file, 2023-11-14]
DRONE 3D/Drone PGE Esamc/Canopy_Tail_V1.5.stl
69.3 x 120.0 x 18.0
