MekhyW/Drone-VFHL-R1/DRONE 3D/Drone PGE Esamc/Frame_38mm_Strut.stl

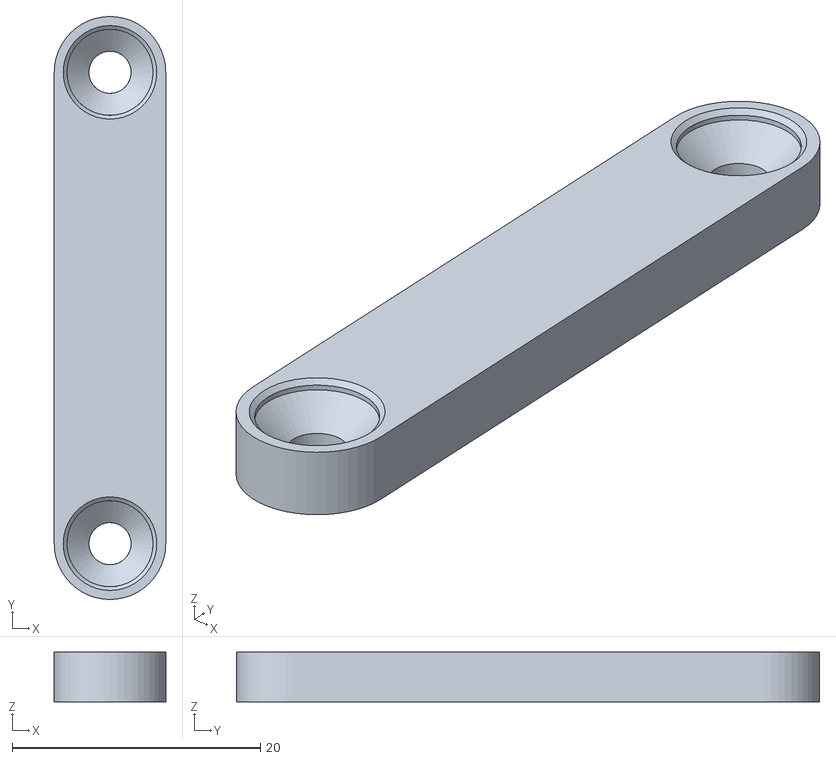
[picture p101: CAD file, 2023-11-14]
DRONE 3D/Drone PGE Esamc/Frame_38mm_Strut.stl
9.00 x 47.0 x 4.00
