MekhyW/Drone-VFHL-R1/DRONE 3D/Drone PGE Esamc/Frame_Base_Plate_90mm_V1.5.stl

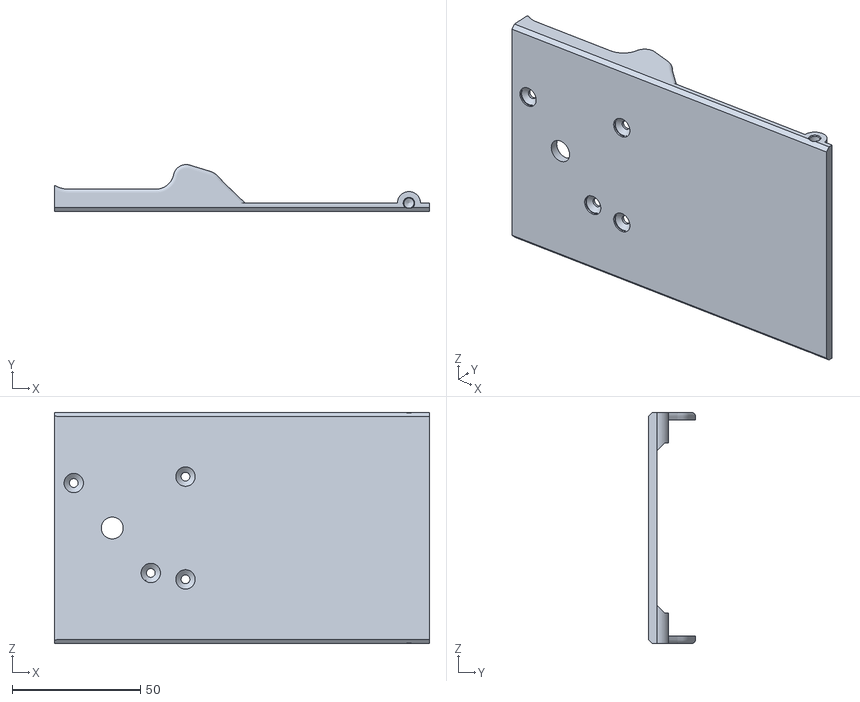
[picture p102: CAD file, 2023-11-14]
DRONE 3D/Drone PGE Esamc/Frame_Base_Plate_90mm_V1.5.stl
146.0 x 18.3 x 90.0
