MekhyW/Drone-VFHL-R1/DRONE 3D/Drone PGE Esamc/Servo_Cap_M8.stl

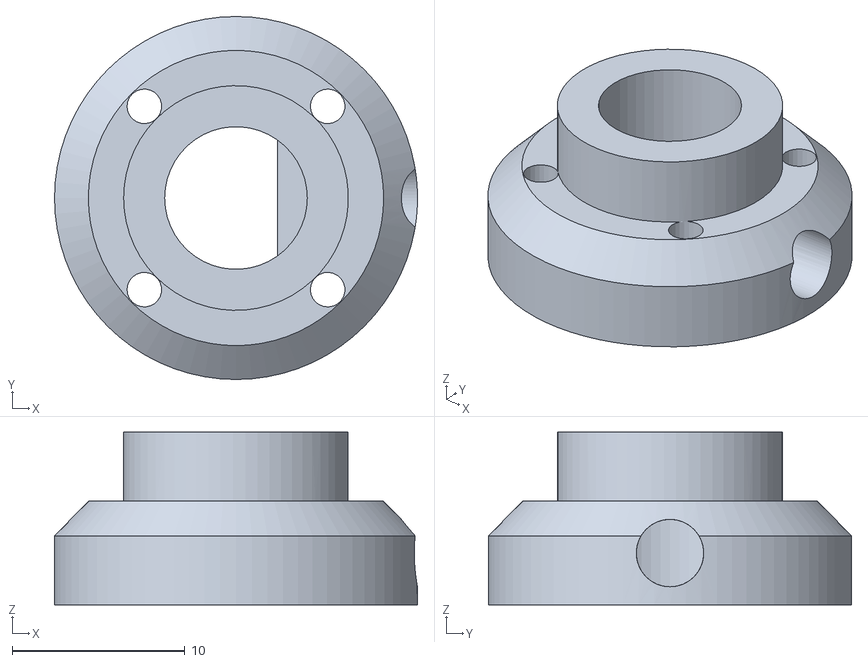
[picture p104: CAD file, 2023-11-14]
DRONE 3D/Drone PGE Esamc/Servo_Cap_M8.stl
21.0 x 21.0 x 10.0
