MekhyW/Drone-VFHL-R1/DRONE 3D/Drone PGE Esamc/Boom_Outer_Joint_1.stl

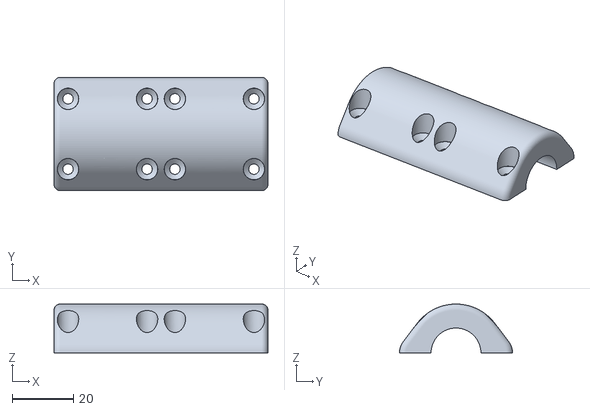
[picture p105: CAD file, 2023-11-14]
DRONE 3D/Drone PGE Esamc/Boom_Outer_Joint_1.stl
70.0 x 37.0 x 16.0
