MekhyW/Drone-VFHL-R1/(list of files, cad)

Other CAD files:
DRONE 3D/Drone PGE Esamc/Boom_Rod_Linkage_20Deg_R.stl
DRONE 3D/Drone PGE Esamc/Boom_Outer_Joint_2_20Deg_L.stl
DRONE 3D/Drone PGE Esamc/Boom_Joint_20Deg_L.stl
DRONE 3D/Drone PGE Esamc/Wormdrive_Endstops_V1.5_M8Round.stl
DRONE 3D/Drone PGE Esamc/Servo_Cap_M5.stl
DRONE 3D/CASE ESP32 CAM - Tampa.ipt
DRONE 3D/CASE ESP32 CAM.ipt
DRONE 3D/DRONE.ipt
DRONE 3D/Drone PGE Esamc/Wormdrive_Endstops_V1.5_for_M5_Nut.stl
DRONE 3D/Drone PGE Esamc/Wormdrive_Endstops_V1.5_for_Quarter-20_Nut.stl
DRONE 3D/Drone PGE Esamc/Wormdrive_V1.5_for_M5_Nut.stl
DRONE 3D/Drone PGE Esamc/Wormdrive_V1.5_for_M8_Nut.stl
DRONE 3D/Drone PGE Esamc/Wormdrive_V1.5_for_Quarter-20_Nut.stl
DRONE 3D/OldVersions/CASE ESP32 CAM - Tampa.0002.ipt
DRONE 3D/OldVersions/CASE ESP32 CAM.0001.ipt
DRONE 3D/OldVersions/DRONE.0001.ipt
