MekhyW/Drone-VFHL-R1/Camera Thermal/amg8833_arduino_wiring.png

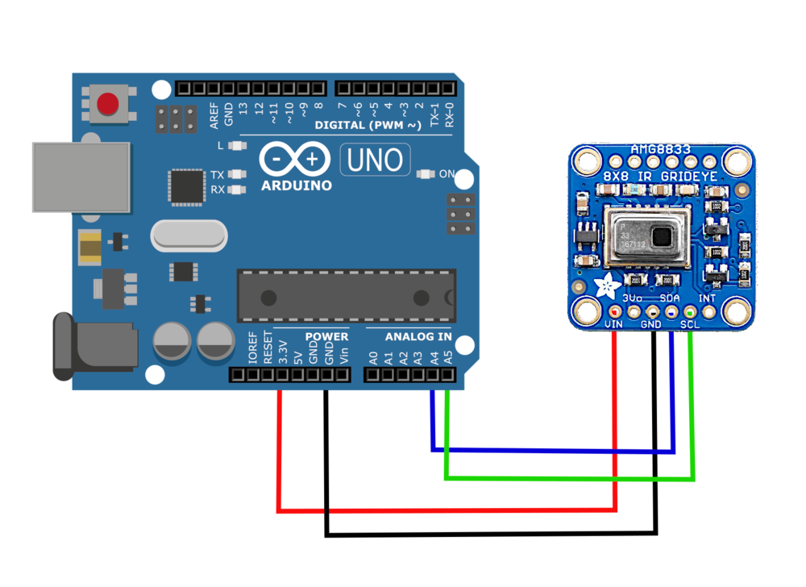
Camera Thermal/amg8833_arduino_wiring.png
