MekhyW/Drone-VFHL-R1/(list of files, drawings)

Other design files:
PCB/PCB.DSN
PCB/PCB.LYT
