MekhyW/Drone-VFHL-R1/Camera Thermal/Camera Thermal/Camera Thermal/Sensor e Display Temp/sketch_sep17a/sketch_sep23a/sketch_sep23a.ino

/*
      Projeto Medidor de Temperatura
*/

//biblioteca do LCD
#include <LiquidCrystal.h>

//portas do Arduino para cada pino do LCD
const int rs = 8, en = 9, d4 = 4, d5 = 5, d6 = 6, d7 = 7;
LiquidCrystal lcd(rs, en, d4, d5, d6, d7); 

//temperaturaC ambiente do lugar em que estiver para que as LED's acendam com base nisso
int tempMin = 10;

int tempMax = 40;

//Array que desenha o simbolo de grau
byte a[8]= {B00110,B01001,B00110,B00000,B00000,B00000,B00000,B00000,}; 

//variável de leitura do sensor
const int sensorLM35 = A0; 
       
int i;
float temperaturaC = 0;

void setup() {

  //Inicializa comunicação serial
  Serial.begin(9600);

  //Método de percorrer os pinos e ao mesmo tempo declara-los como saída 
  for(i=8; i<12; i++){
    pinMode(i, OUTPUT);
  }

  //Inicializa o LCD e posteriormente exibe a temperaturaC e a tensão
  lcd.begin(16, 2);
  lcd.print("Temp: ");
  lcd.setCursor(0, 2);
  lcd.print("Tensao: ");
  lcd.setCursor(12, 2);
  lcd.print("V");

  //Atribui a "1" o valor do array "A", que desenha o simbolo de grau
  lcd.createChar(1, a);
  //Coloca o cursor na coluna 7, linha 1 
  lcd.setCursor(10,0); 
  //Escreve o simbolo de grau
  lcd.write(1);
}            

void loop() {

  //Variável que faz a leitura do sensor
  int valorSensor = analogRead(sensorLM35);

  //Conversao da leitura do sensor em tensão V
  float tensao = (valorSensor/1024.0)*5.0;

   //Divide a variavel temperaturaC por 8, para obter precisão na medição
  temperaturaC = (tensao)* 100.0; 

  //Conversão de Celsius para Fahrenheit
  float temperaturaF = (temperaturaC*9)/5 + 32;

  //mostra no monitor serial o valor lido
  Serial.print("Valor do sensor: ");       
  Serial. print(valorSensor);

  
    //Mostra no monitor serial a tensão lida
  Serial.print(", Tensao (V): ");          
  Serial.print(tensao); 
  
  //Mostra no monitor serial os graus lidos
  Serial.print(", Celsius: ");
  Serial.print(temperaturaC);
  
  //Printa no serial monitor o valor convertido
  Serial.print(", Fahrenheit: ");
  Serial.println(temperaturaF);

  delay(1000); 
  lcd.setCursor(6, 0);
  //Escreve no display o valor da temperaturaC
  lcd.print(temperaturaC,1);

  lcd.setCursor(8, 1);
  //Escreve no display o valor da tensão
  lcd.print(tensao,2); 
  
  if(temperaturaC < tempMin){      //se a temperaturaC lida for inferior a 27 °C
    digitalWrite(10, LOW);            //acende led da porta 10 - Red
    digitalWrite(11, HIGH);            //apaga led da porta 11 - Green
        
  }else if(temperaturaC >= tempMax){  //se a temperaturaC lida estiver entre 27 ºC e 31 ºC
    digitalWrite(10, HIGH);           //apaga led da porta 10 - Red
    digitalWrite(11, LOW);            //acende led da porta 11 - Green
  
  delay(1000);
  }
}
