MekhyW/Drone-VFHL-R1/ESP32/CameraWebServer/camera_index.h

//File: index_ov2640.html.gz, Size: 4316
#define index_ov2640_html_gz_len 4316
const uint8_t index_ov2640_html_gz[] = {
 0x1F, 0x8B, 0x08, 0x08, 0x50, 0x5C, 0xAE, 0x5C, 0x00, 0x03, 0x69, 0x6E, 0x64, 0x65, 0x78, 0x5F,
 0x6F, 0x76, 0x32, 0x36, 0x34, 0x30, 0x2E, 0x68, 0x74, 0x6D, 0x6C, 0x00, 0xE5, 0x5D, 0x7B, 0x73,
 0xD3, 0xC6, 0x16, 0xFF, 0x9F, 0x4F, 0x21, 0x04, 0x25, 0xF6, 0x34, 0x76, 0x6C, 0xC7, 0x84, 0xE0,
 0xDA, 0xE2, 0x42, 0x08, 0xD0, 0x19, 0x5E, 0x25, 0x2D, 0x74, 0xA6, 0xD3, 0x81, 0xB5, 0xB4, 0xB2,
 0x55, 0x64, 0xC9, 0x95, 0x56, 0x76, 0x52, 0x26, 0x9F, 0xE3, 0x7E, 0xA0, 0xFB, 0xC5, 0xEE, 0xD9,
 0x87, 0xA4, 0x95, 0xBC, 0x7A, 0xD8, 0x26, 0x36, 0x97, 0xEB, 0xCC, 0x14, 0xD9, 0xDA, 0x73, 0xF6,
 0x9C, 0xF3, 0x3B, 0xAF, 0x5D, 0x3D, 0x3A, 0xBC, 0x6D, 0xF9, 0x26, 0xB9, 0x9A, 0x63, 0x6D, 0x4A,
 0x66, 0xAE, 0x71, 0x6B, 0xC8, 0xFF, 0xD1, 0xE0, 0x33, 0x9C, 0x62, 0x64, 0xF1, 0x43, 0xF6, 0x75,
 0x86, 0x09, 0xD2, 0xCC, 0x29, 0x0A, 0x42, 0x4C, 0x46, 0x7A, 0x44, 0xEC, 0xD6, 0xA9, 0x9E, 0x3F,
 0xED, 0xA1, 0x19, 0x1E, 0xE9, 0x0B, 0x07, 0x2F, 0xE7, 0x7E, 0x40, 0x74, 0xCD, 0xF4, 0x3D, 0x82,
 0x3D, 0x18, 0xBE, 0x74, 0x2C, 0x32, 0x1D, 0x59, 0x78, 0xE1, 0x98, 0xB8, 0xC5, 0xBE, 0x1C, 0x3A,
 0x9E, 0x43, 0x1C, 0xE4, 0xB6, 0x42, 0x13, 0xB9, 0x78, 0xD4, 0x95, 0x79, 0x11, 0x87, 0xB8, 0xD8,
 0x38, 0xBF, 0x78, 0x7B, 0xDC, 0xD3, 0xDE, 0xBC, 0xEF, 0xF5, 0x4F, 0x3A, 0xC3, 0x23, 0xFE, 0x5B,
 0x3A, 0x26, 0x24, 0x57, 0xF2, 0x77, 0xFA, 0x19, 0xFB, 0xD6, 0x95, 0xF6, 0x25, 0xF3, 0x13, 0xFD,
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
 0xC0, 0xC7, 0x1A, 0x95, 0x0B, 0x62, 0x46, 0xB5, 0x88, 0x3E, 0x6C, 0xD8, 0xA7, 0x42, 0xCA, 0x61,
 0x9F, 0xD2, 0x00, 0xD2, 0xE8, 0xC8, 0xD9, 0x17, 0xE1, 0xA5, 0x4A, 0x98, 0x87, 0x19, 0xFB, 0xCC,
 0xD1, 0x55, 0xBD, 0x10, 0xBB, 0x68, 0x50, 0x84, 0x21, 0x94, 0x59, 0xAB, 0x06, 0x43, 0x97, 0x33,
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
};
